shavyy/Automated_Chess/20_schema/Hall sensor board/readme.txt

https://easyeda.com/editor#id=ab28c445c3c246c5a2a266b23222d452|cde10e1112164b658e3af7a17f8cf5f8|bc72eab7fff44d6e881abe3bf44bdedf
