shavyy/Automated_Chess/00_Datasheet/sg90_spec.png

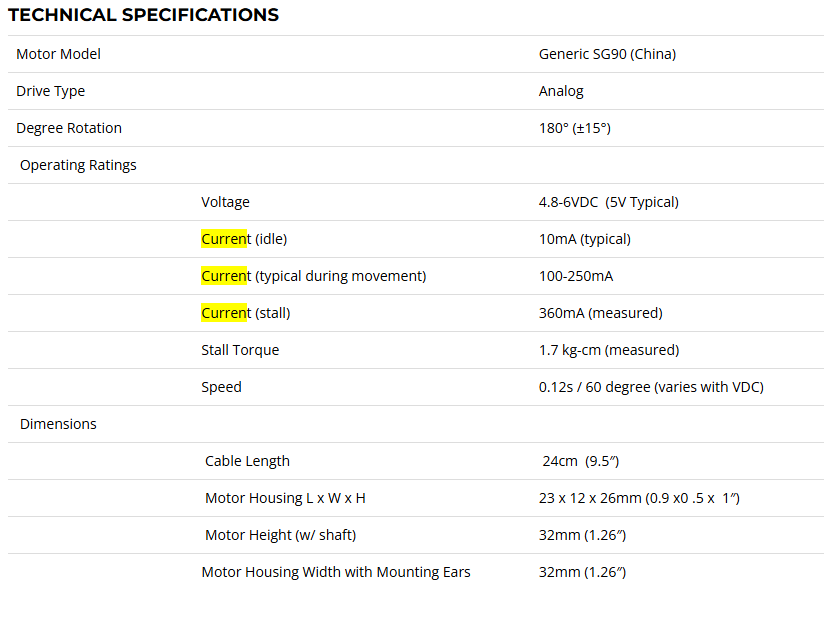
00_Datasheet/sg90_spec.png
