shavyy/Automated_Chess/10_Image/01630_6.jpg

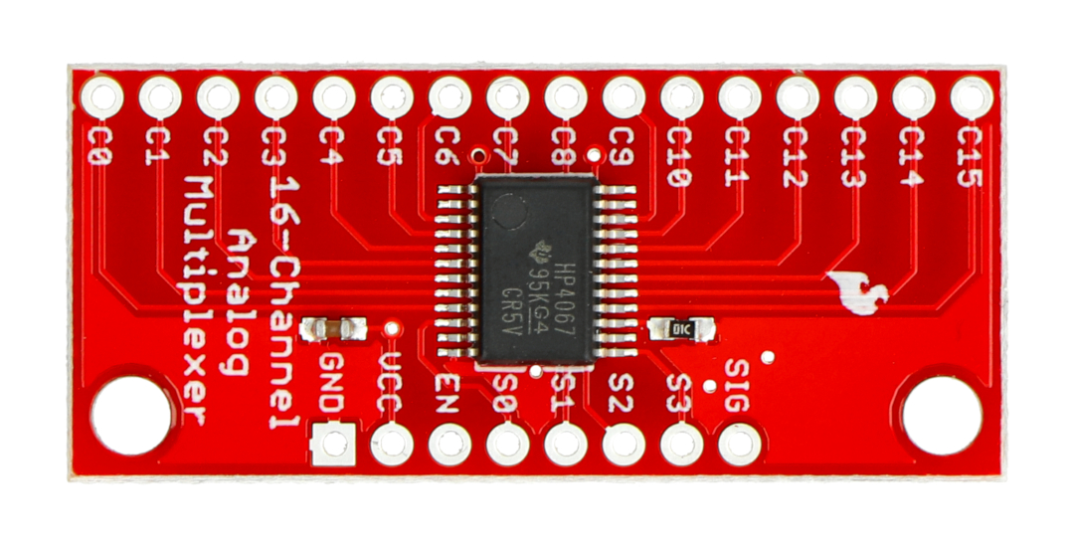
10_Image/01630_6.jpg
