shavyy/Automated_Chess/10_Image/arbredeDécision0.jpg

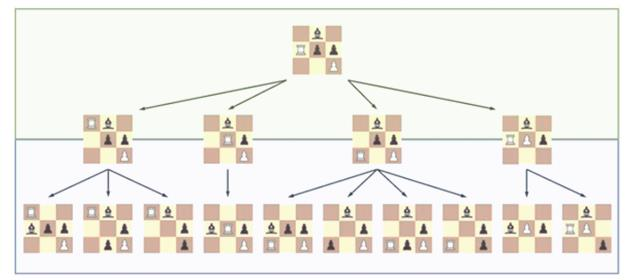
10_Image/arbredeDécision0.jpg
