shavyy/Automated_Chess/10_Image/arbreDeDécision1.jpg

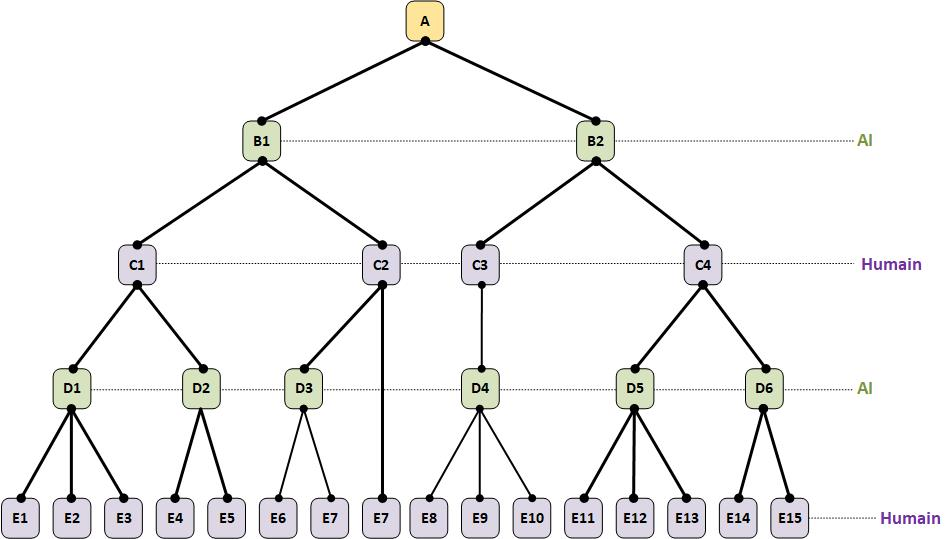
10_Image/arbreDeDécision1.jpg
