shavyy/Automated_Chess/10_Image/arbredeDécision2.jpg

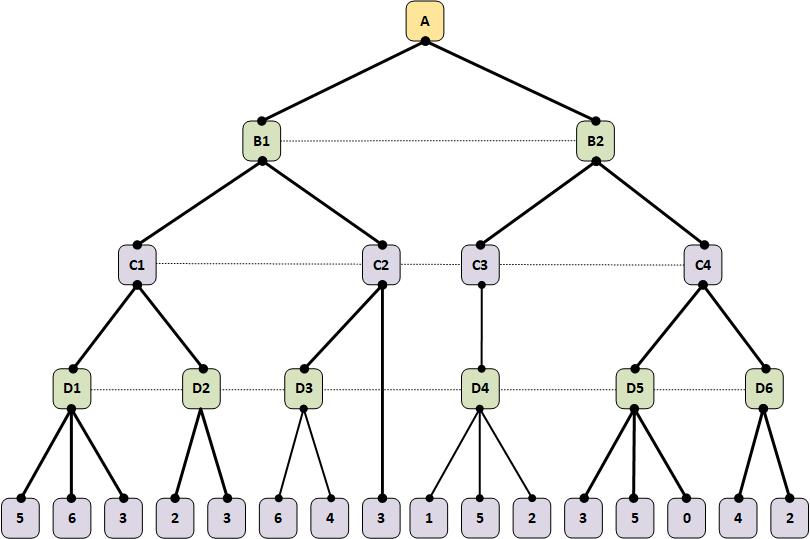
10_Image/arbredeDécision2.jpg
