shavyy/Automated_Chess/10_Image/arbredeDécision3.jpg

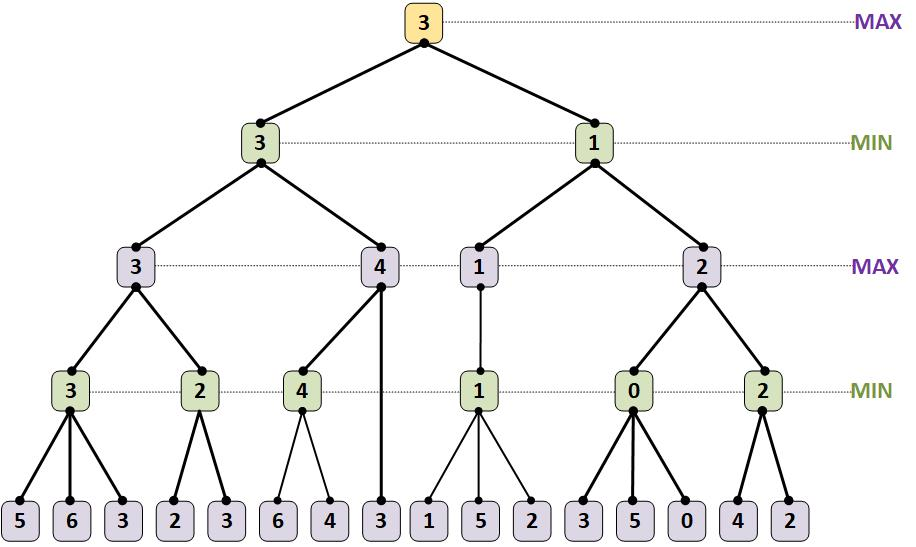
10_Image/arbredeDécision3.jpg
