shavyy/Automated_Chess/10_Image/arbreDeDécision4.jpg

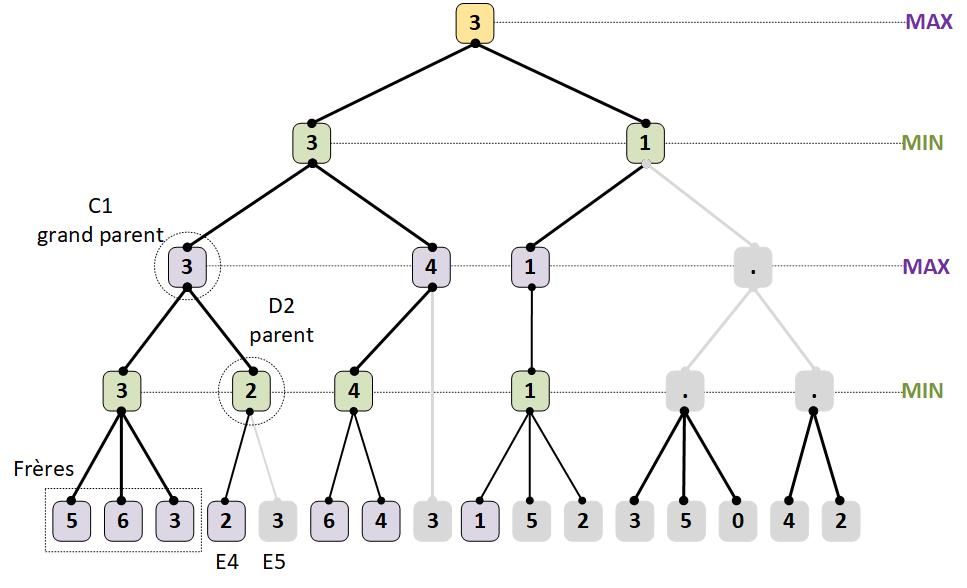
10_Image/arbreDeDécision4.jpg
