shavyy/Automated_Chess/10_Image/arduino_uno_bouton_poussoir.png

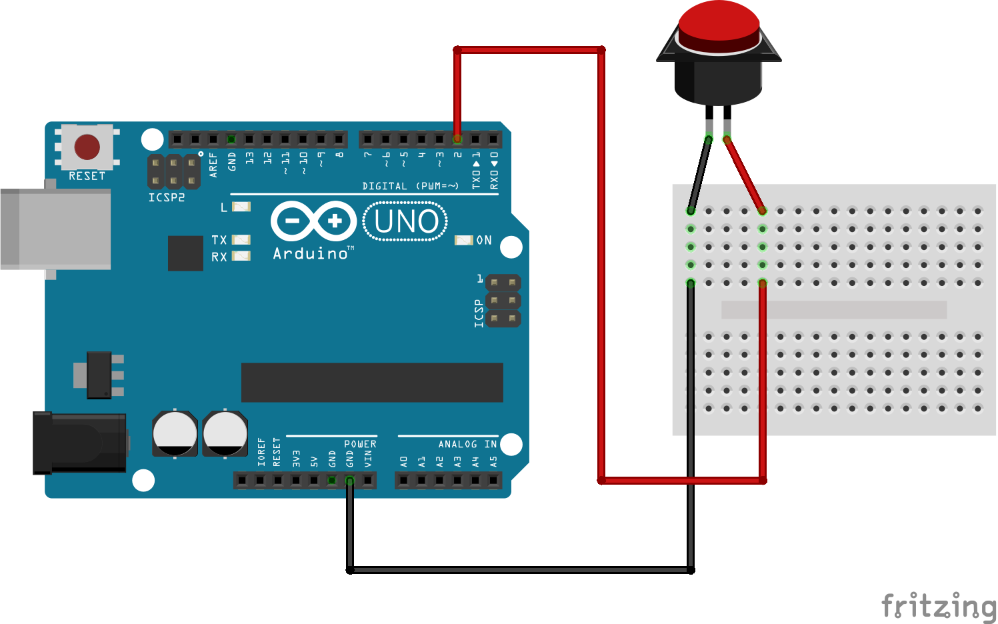
10_Image/arduino_uno_bouton_poussoir.png
