shavyy/Automated_Chess/10_Image/buzzer.jpg

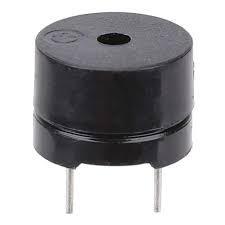
10_Image/buzzer.jpg
