shavyy/Automated_Chess/10_Image/DRV8825-Stepper-Driver-Pinout.jpg

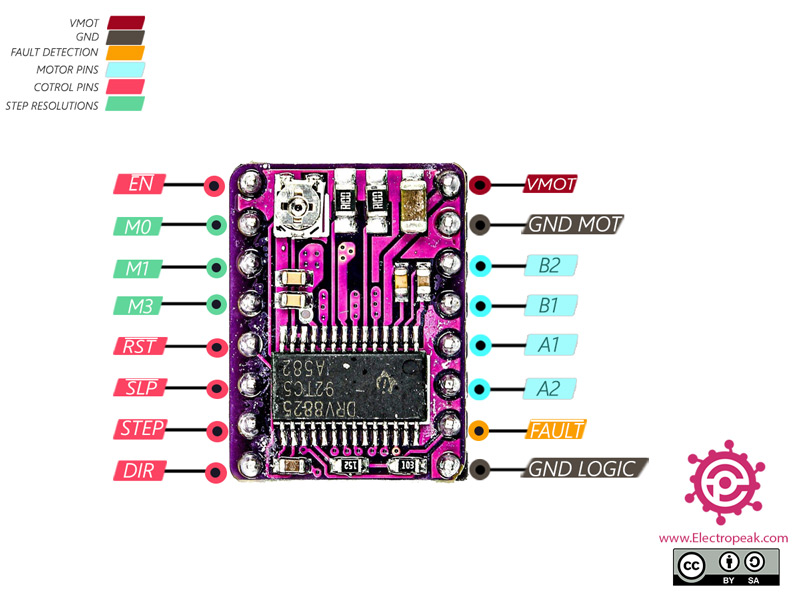
10_Image/DRV8825-Stepper-Driver-Pinout.jpg
