shavyy/Automated_Chess/10_Image/Interfacing-NEMA17-Stepper-Motor-with-ESP8266-using-DRV8825.jpg

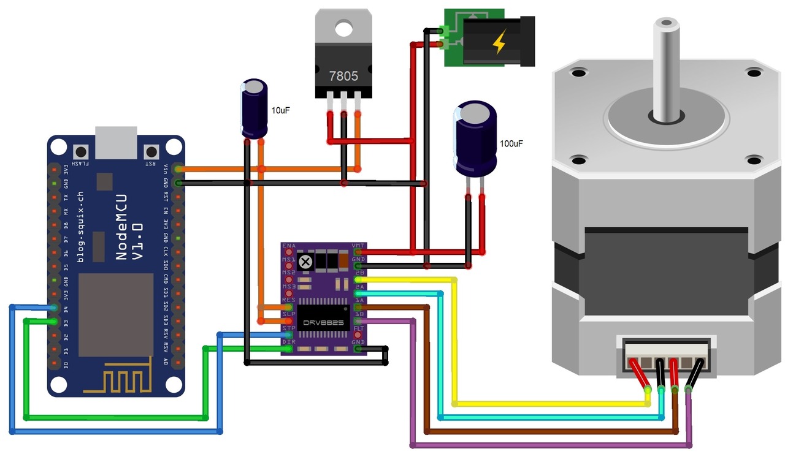
10_Image/Interfacing-NEMA17-Stepper-Motor-with-ESP8266-using-DRV8825.jpg
