shavyy/Automated_Chess/10_Image/layout_41uyAShgS7.jpg

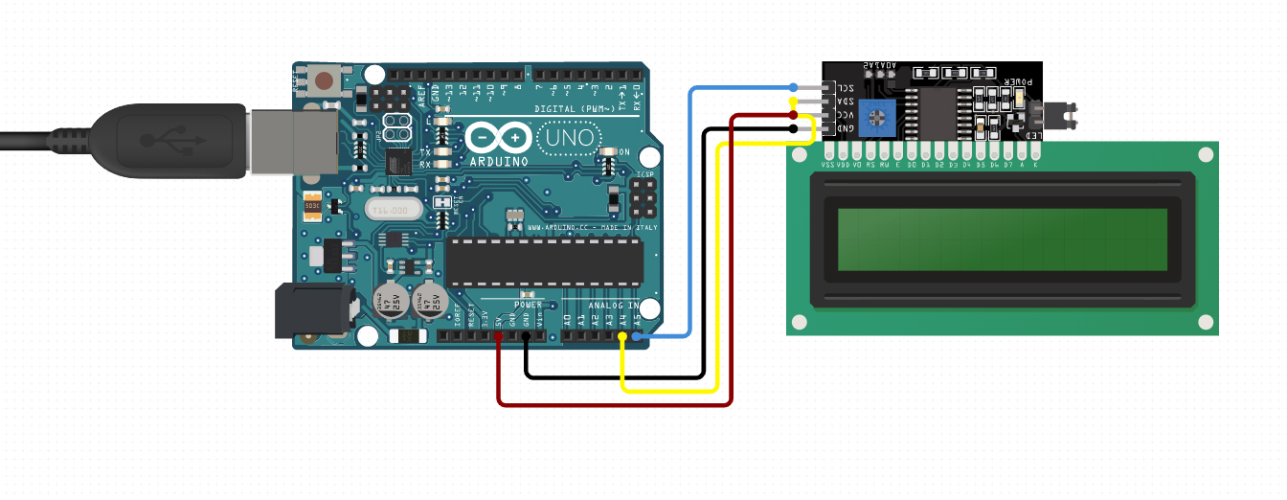
10_Image/layout_41uyAShgS7.jpg
