shavyy/Automated_Chess/10_Image/microswitch-edmatyer.jpg

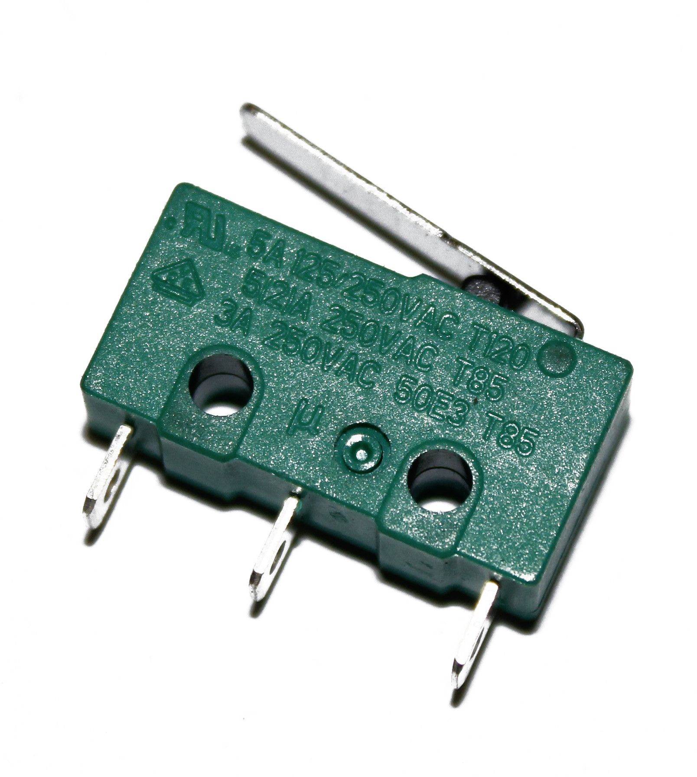
10_Image/microswitch-edmatyer.jpg
