shavyy/Automated_Chess/10_Image/motor-driver-dual-h-bridge-l298n-2.jpg

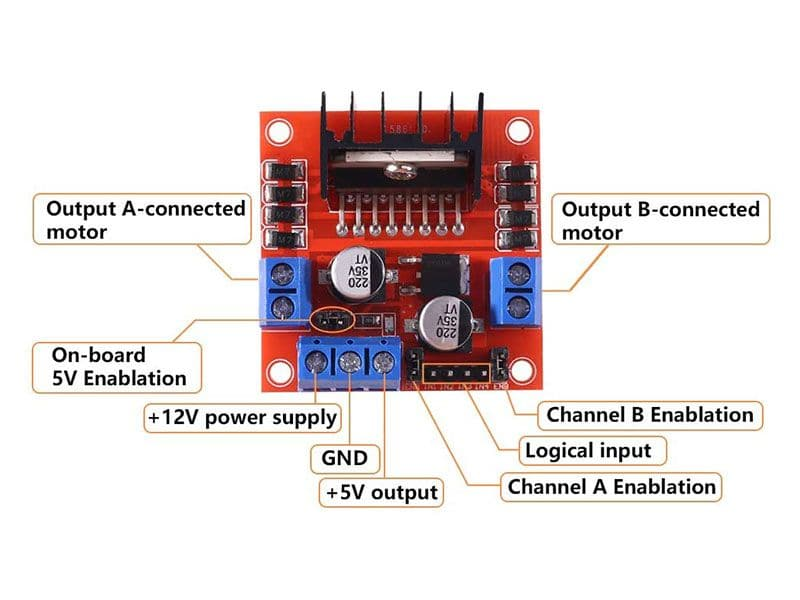
10_Image/motor-driver-dual-h-bridge-l298n-2.jpg
