shavyy/Automated_Chess/10_Image/NEMA17.jpg

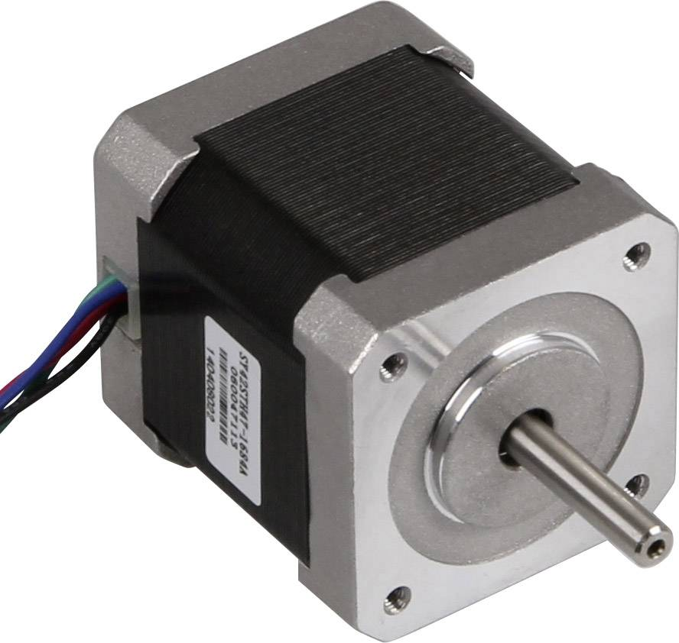
10_Image/NEMA17.jpg
