shavyy/Automated_Chess/10_Image/power-supply-12v-arduino-125-a-21-mm-jack.jpg

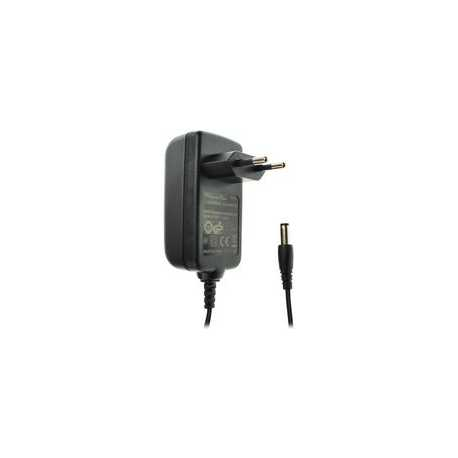
10_Image/power-supply-12v-arduino-125-a-21-mm-jack.jpg
