shavyy/Automated_Chess/10_Image/téléchargement.jpg

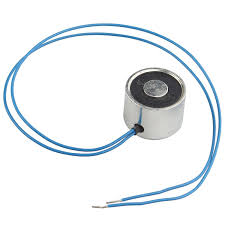
10_Image/téléchargement.jpg
