shavyy/Automated_Chess/10_Image/WdUnn.png

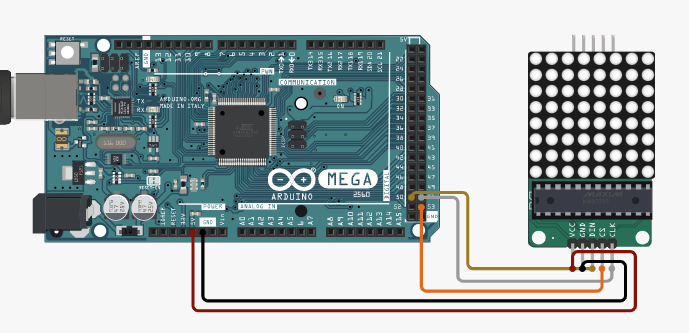
10_Image/WdUnn.png
