shavyy/Automated_Chess/20_schema/Hall sensor board/Schematic_automated_chess_2025-01-17.png

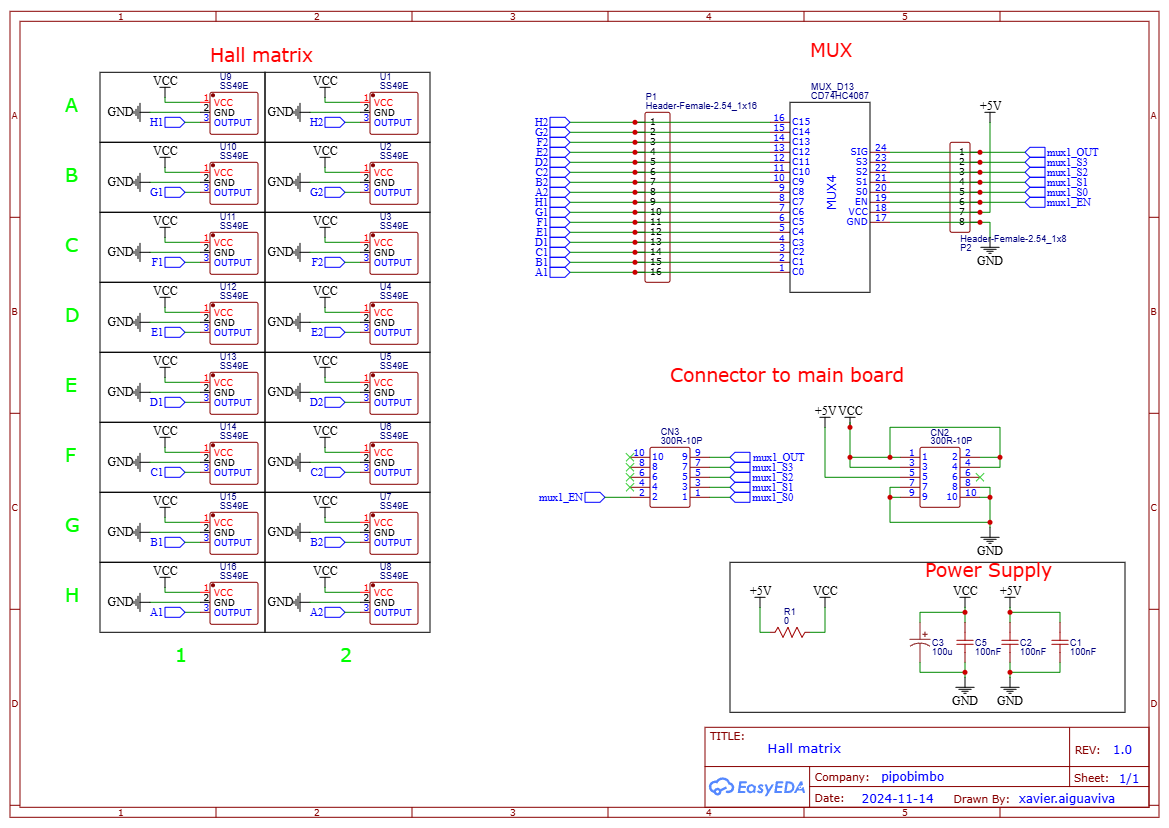
20_schema/Hall sensor board/Schematic_automated_chess_2025-01-17.png
