shavyy/Automated_Chess/BOM.xlsx

Sheet: Total
Type | Price
Electronic | 114.26 €
xy table | 27.38 €
Transmission | 17.10 €
box | 3.69 €
bolting | 22.97 €
Chess | 7.69 €
Impression 3D | 89.82 €
282.91 €

Sheet: electronic
Cart | Ordered | Received |  | Qty | Price U | Price tot
OK | OK | OK | 2 x Stepper Motor - Adafruit - Nema 17 size - 200 steps/rev, 12V 350mA 12V | 2 | 17.37 | 34.74 |  | https://www.amazon.fr/STEPPERONLINE-Bipolaire-42x34mm-Imprimante-Machine/dp/B00PNEQ9T4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
OK | OK | OK | 5Pcs DRV8825 Stepper Driver + Mega2560 Motherboard + Ramps1.4 Control Panel for 3D Printer | 1 | 18.59 | 18.59 |  | https://fr.aliexpress.com/item/1005004858805354.html?utparam-url=scene%3Asearch%7Cquery_from%3A
 |  |  | 1 x LCD Module - I2C Serial - 2.6“ | 0 |  | 0.00
 |  |  | 2 x Arcade button - Bore hole 23.5 mm | 0 |  | 0.00
OK | OK | OK | 1 x Electromagnet - 15Kg Holding Force 12V D30H25 | 2 | 3.03 | 6.06 | x1 | https://fr.aliexpress.com/item/1005007265254207.html?utparam-url=scene%3Asearch%7Cquery_from%3A
OK | OK | OK | L298N | 3 | 1.80 | 5.40 | x1 | https://fr.aliexpress.com/item/32392774289.html?utparam-url=scene%3Asearch%7Cquery_from%3A
 |  |  | 2 x Micro Limit switch roller | 0 |  | 0.00
OK | OK | OK | 64x EPLZON 49E OH49E SS49E TO-92S | 7 | 1.63 | 11.41 | x10 | https://fr.aliexpress.com/item/1005006061649001.html?utparam-url=scene%3Asearch%7Cquery_from%3A
OK | OK | OK | 4 x MUX breakout - SparkFun - CD74HC4067 | 1 | 4.59 | 4.59 | x10 | https://fr.aliexpress.com/item/1005006477925546.html?utparam-url=scene%3Asearch%7Cquery_from%3A
 |  |  | 3 x Prototyping Board - 50 x 100 mm | 0 |  | 0.00
OK | OK | OK | Female Headers | 2 | 1.52 | 3.04 | x10 | https://fr.aliexpress.com/item/4001198421663.html?utparam-url=scene%3Asearch%7Cquery_from%3A
 |  |  | 8 x Ribbon Cable - 8 | 0 | 7.99 | 0.00 | 6m | https://www.amazon.fr/QWORK-Couleur-Arc-En-Ciel-broches-Connecteurs/dp/B09R42ZGQD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
 |  |  | 1x Power supply 12V | 0 | 9.79 | 0.00 |  | https://www.amazon.fr/Transformateur-Adaptateur-Bande-Alimentation-V-220/dp/B01G0Q3RWU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
OK | OK | OK | 1x Power supply 12V | 1 | 3.65 | 3.65 |  | https://fr.aliexpress.com/item/1005006237300485.html?utparam-url=scene%3Asearch%7Cquery_from%3A
OK | OK | OK | 1x Power supply 5V | 1 | 2.44 | 2.44 |  | https://fr.aliexpress.com/item/1005006975464963.html?utparam-url=scene%3Asearch%7Cquery_from%3A
OK | OK | OK | kit resistor | 1 | 2.64 | 2.64 | x300 | https://fr.aliexpress.com/item/1005004933865451.html?utparam-url=scene%3Asearch%7Cquery_from%3A
OK | OK | OK | Etain | 2 | 2.05 | 4.10 |  | https://fr.aliexpress.com/item/1005006310000213.html?utparam-url=scene%3Asearch%7Cquery_from%3A
OK | OK | OK | wire | 1 | 1.30 | 1.30 | x120 | https://fr.aliexpress.com/item/1005007080948429.html?utparam-url=scene%3Asearch%7Cquery_from%3A
OK | OK | OK | PCB Hall sensor | 5 | 3.26 | 16.30
 |  |  |  |  |  | 114.26 €

Sheet: xy table
Cart | Ordered | Received |  | qty | Price U | Price tot
OK | OK | OK | 2 x V slot 20x20 linear rail, Length = 345 mm | 1 | 16.39 € | 16.39 € | x4 400mm | https://fr.aliexpress.com/item/1005003299342998.html?src=google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
 |  |  | 1 x V slot 20x20 linear rail, Length = 315 mm | 0 |  | 0.00
 |  |  | 1 x V slot 20x20 linear rail, Length = 350 mm | 0 |  | 0.00
 |  |  | 1 x V slot 20x20 linear rail, Length = 395 mm | 0 |  | 0.00
OK | OK | OK | 10 x 90 degree Corner Bracket | 1 | 10.99 | 10.99 | x10 | https://www.amazon.fr/AUTOUTLET-%C3%A9querres-int%C3%A9rieures-rainur%C3%A9es-Aluminium/dp/B07PJNNP6N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
 |  |  |  |  |  | 27.38 €

Sheet: Transmission
Cart | Ordered | Received |  | qty | Price U | Price tot
OK | OK | OK | 2 x GT2 Pulley, 20 teeth, 5mm bore | 1 | 5.29 € | 5.29 € | x2 | https://fr.aliexpress.com/item/33002989677.html?utparam-url=scene%3Asearch%7Cquery_from%3A
OK | OK | OK | 8 x GT2 Toothless pulley | 1 | 8.49 | 8.49 | x10 | https://fr.aliexpress.com/item/1005003693817340.html?utparam-url=scene%3Asearch%7Cquery_from%3A
OK | OK | OK | 3.5m x GT2 Belt | 1 | 3.32 | 3.32 | 5m | https://fr.aliexpress.com/item/10000401582873.html?utparam-url=scene%3Asearch%7Cquery_from%3A
 |  |  |  |  |  | 17.10 €

Sheet: box
Cart | Ordered | Received |  | qty | Price U | Price tot
OK | OK | OK | 1 x Foamboard - 462 x 462 x 5 mm | 1 | 3.69 € | 3.69 € | x3 | https://fr.aliexpress.com/item/1005006306052205.html?utparam-url=scene%3Asearch%7Cquery_from%3A
 |  |  | 1 x Foamboard - 462 x 462 x 10 mm | 0 |  | 0.00
 |  |  | 2 x Foamboard - 462 x 80 x 10 mm | 0 |  | 0.00
 |  |  | 2 x Foamboard - 442 x 80 x 10 mm | 0 |  | 0.00
 |  |  |  |  |  | 3.69 €

Sheet: bolting
Cart | Ordered | Received |  | qty | Price U | Price tot
OK | OK | OK | 8 x Mini V Wheel | 1 | 8.59 € | 8.59 € | x12 | https://fr.aliexpress.com/item/1005006057691968.html?utparam-url=scene%3Asearch%7Cquery_from%3A
 |  |  | 4 x Aluminium Spacer - ID : 5mm - Height : 6mm | 1 | 7.99 | 7.99 | x40 | https://www.amazon.fr/QUARKZMAN-Entretoise-Aluminium-Ext%C3%A9rieur-M%C3%A9tallique/dp/B0D3G5C3BB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
OK | OK | OK | 4 x Eccentric Spacer - M5 | 1 | 7.99 | 7.99 | x40 | https://www.amazon.fr/Evemodel-entretoises-Rondelles-Rangement-Accessoires/dp/B0B2HTRWTY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
 |  |  | 4 x Hex. Locking Nut - M5 | 4 |  | 0.00
 |  |  | 4 x Thin Hex. Nut - M5 | 4 |  | 0.00
 |  |  | 8 x Mini Precision Shim - OD : 8 mm - ID : 5 mm - Thickness : 1 mm | 8 |  | 0.00
OK | OK | OK | 26 x T-Nuts - M5 | 1 | 6.99 | 6.99 | x50 | https://www.amazon.fr/Coulissants-Aluminium-Standard-Europ%C3%A9en-Extrusion/dp/B0B7W5D599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
 |  |  | 14 x Hex. Socket Button Head Cap Screw - M5 x 8 mm | 14 |  | 0.00
 |  |  | 12 x Hex. Socket Button Head Cap Screw - M5 x 12 mm | 12 |  | 0.00
 |  |  | 2 x Hex. Socket Button Head Cap Screw - M5 x 35 mm | 2 |  | 0.00
 |  |  | 2 x Hex. Socket Button Head Cap Screw - M5 x 30 mm | 2 |  | 0.00
 |  |  | 2 x Hex. Socket Button Head Cap Screw - M5 x 25 mm | 2 |  | 0.00
 |  |  | 8 x Hex. Socket Button Head Cap Screw - M5 x 15 mm | 8 |  | 0.00
 |  |  | 4 x Slotted Head Screw - M2 x 15 mm | 4 |  | 0.00
 |  |  | 4 x Nut - M2 | 4 |  | 0.00
 |  |  | 8 x Hex. Socket Head Cap Screw - M3 x 10 mm | 8 |  | 0.00
 |  |  | 1 x Hex. Socket Head Cap Screw - M4 x 15 mm | 1 |  | 0.00
 |  |  | 4 x Slotted Countersunk Head Screw - M5 x 20 mm | 4 |  | 0.00
 |  |  | 4 x Nut - M5 | 4 |  | 0.00
 |  |  |  |  |  | 22.97 €

Sheet: chess
Cart | Ordered | Received |  | Qty | Price U | Price tot
 |  |  | 1 x Chess pieces set - Staunton 3 | 0 |  | 0.00 €
 |  |  | 1 x Chessboard Sticker - Squares size : 37 x 37 mm | 0 |  | 0.00
OK | OK | OK | 32 x Magnet, Dia 8 x 3 mm | 1 | 7.69 | 7.69 | x100 | https://fr.aliexpress.com/item/1005007306506182.html?utparam-url=scene%3Asearch%7Cquery_from%3A
 |  |  |  |  |  | 7.69 €

Sheet: impression 3D
Cart | Ordered | Received |  | qty | Price U | Price tot
OK | OK | OK | Cable_Clip | 2 | 6.07 | 12.14 € | https://www.abeille3d.com/produit/impression-3d/
OK | OK | OK | Electromagnet_Support | 1 | 12.55 | 12.55 €
 |  |  | Electronic_Support_A |  |  | 0.00 €
 |  |  | Electronic_Support_B |  |  | 0.00 €
OK | OK | OK | Motor_Support_A | 1 | 12.63 € | 12.63 €
OK | OK | OK | Motor_Support_B | 1 | 12.63 € | 12.63 €
OK | OK | OK | Pulley_Support_A | 1 | 10.16 | 10.16 €
OK | OK | OK | Pulley_Support_B | 1 | 10.12 | 10.12 €
OK | OK | OK | Trolley_Support_A | 1 | 9.87 | 9.87 €
OK | OK | OK | Trolley_Support_B | 1 | 9.72 | 9.72 €
 |  |  |  |  |  | 89.82 €
