shavyy/Automated_Chess/100_Design/Design.xlsx

Sheet: Mapping AT2560
Atemga 2560
Pin Number | Pin Name | Mapped pin name | Component | Pin Name
1 | PG5 ( OC0B ) | Digital pin 4 (PWM) | Micro switch | LIMIT_SWITCH_WHITE
2 | PE0 ( RXD0/PCINT8 ) | Digital pin 0 (RX0)
3 | PE1 ( TXD0 ) | Digital pin 1 (TX0)
4 | PE2 ( XCK0/AIN0 )
5 | PE3 ( OC3A/AIN1 ) | Digital pin 5 (PWM) | Micro switch | LIMIT_SWITCH_WHITE
6 | PE4 ( OC3B/INT4 ) | Digital pin 2 (PWM)
7 | PE5 ( OC3C/INT5 ) | Digital pin 3 (PWM) | Mux | EN_MUX4
8 | PE6 ( T3/INT6 )
9 | PE7 ( CLKO/ICP3/INT7 )
10 | VCC | VCC
11 | GND | GND
12 | PH0 ( RXD2 ) | Digital pin 17 (RX2)
13 | PH1 ( TXD2 ) | Digital pin 16 (TX2)
14 | PH2 ( XCK2 )
15 | PH3 ( OC4A ) | Digital pin 6 (PWM)
16 | PH4 ( OC4B ) | Digital pin 7 (PWM)
17 | PH5 ( OC4C ) | Digital pin 8 (PWM)
18 | PH6 ( OC2B ) | Digital pin 9 (PWM)
19 | PB0 ( SS/PCINT0 ) | Digital pin 53 (SS) | LED matrix | CS
20 | PB1 ( SCK/PCINT1 ) | Digital pin 52 (SCK) | LED matrix | CLK
21 | PB2 ( MOSI/PCINT2 ) | Digital pin 51 (MOSI) | LED matrix | DIN
22 | PB3 ( MISO/PCINT3 ) | Digital pin 50 (MISO) | Servo_MOT | Servo_MOT
23 | PB4 ( OC2A/PCINT4 ) | Digital pin 10 (PWM)
24 | PB5 ( OC1A/PCINT5 ) | Digital pin 11 (PWM) | Button White | BUTTON_WHITE_SWITCH_MOTOR_WHITE
25 | PB6 ( OC1B/PCINT6 ) | Digital pin 12 (PWM)
26 | PB7 ( OC0A/OC1C/PCINT7 ) | Digital pin 13 (PWM)
27 | PH7 ( T4 )
28 | PG3 ( TOSC2 )
29 | PG4 ( TOSC1 )
30 | RESET | RESET
31 | VCC | VCC
32 | GND | GND
33 | XTAL2 | XTAL2
34 | XTAL1 | XTAL1
35 | PL0 ( ICP4 ) | Digital pin 49
36 | PL1 ( ICP5 ) | Digital pin 48
37 | PL2 ( T5 ) | Digital pin 47
38 | PL3 ( OC5A ) | Digital pin 46 (PWM)
39 | PL4 ( OC5B ) | Digital pin 45 (PWM)
40 | PL5 ( OC5C ) | Digital pin 44 (PWM) | Mux | EN_MUX2
41 | PL6 | Digital pin 43
42 | PL7 | Digital pin 42 | Mux | EN_MUX3
43 | PD0 ( SCL/INT0 ) | Digital pin 21 (SCL) | LCD | LCD_SCL
44 | PD1 ( SDA/INT1 ) | Digital pin 20 (SDA) | LCD | LCD_SDA
45 | PD2 ( RXDI/INT2 ) | Digital pin 19 (RX1) | H-bridge Magnet | Enable
46 | PD3 ( TXD1/INT3 ) | Digital pin 18 (TX1) | H-bridge Magnet | IN2
47 | PD4 ( ICP1 )
48 | PD5 ( XCK1 )
49 | PD6 ( T1 )
50 | PD7 ( T0 ) | Digital pin 38
51 | PG0 ( WR ) | Digital pin 41
52 | PG1 ( RD ) | Digital pin 40 | Mux | EN_MUX4
53 | PC0 ( A8 ) | Digital pin 37
54 | PC1 ( A9 ) | Digital pin 36 | Motor Black | MOTOR_BLACK_DIR
55 | PC2 ( A10 ) | Digital pin 35
56 | PC3 ( A11 ) | Digital pin 34 | Motor Black | MOTOR_BLACK_STEP
57 | PC4 ( A12 ) | Digital pin 33
58 | PC5 ( A13 ) | Digital pin 32
59 | PC6 ( A14 ) | Digital pin 31
60 | PC7 ( A15 ) | Digital pin 30 | Motor Black | MOTOR_BLACK_EN
61 | VCC | VCC
62 | GND | GND
63 | PJ0 ( RXD3/PCINT9 ) | Digital pin 15 (RX3)
64 | PJ1 ( TXD3/PCINT10 ) | Digital pin 14 (TX3) | Mux | EN_MUX4
65 | PJ2 ( XCK3/PCINT11 )
66 | PJ3 ( PCINT12 )
67 | PJ4 ( PCINT13 )
68 | PJ5 ( PCINT14 )
69 | PJ6 ( PCINT 15 )
70 | PG2 ( ALE ) | Digital pin 39
71 | PA7 ( AD7 ) | Digital pin 29
72 | PA6 ( AD6 ) | Digital pin 28 | Motor White | MOTOR_WHITE_STEP
73 | PA5 ( AD5 ) | Digital pin 27
74 | PA4 ( AD4 ) | Digital pin 26 | Motor White | MOTOR_WHITE_DIR
75 | PA3 ( AD3 ) | Digital pin 25 | Mux | EN_MUX4
76 | PA2 ( AD2 ) | Digital pin 24
77 | PA1 ( AD1 ) | Digital pin 23 | Motort White | MOTOR_WHITE_EN
78 | PA0 ( AD0 ) | Digital pin 22
79 | PJ7
80 | VCC | VCC
81 | GND | GND
82 | PK7 ( ADC15/PCINT23 ) | Analog pin 15 | H-bridge Magnet | IN1
83 | PK6 ( ADC14/PCINT22 ) | Analog pin 14
84 | PK5 ( ADC13/PCINT21 ) | Analog pin 13
85 | PK4 ( ADC12/PCINT20 ) | Analog pin 12 | MUX | S3
86 | PK3 ( ADC11/PCINT19 ) | Analog pin 11 | MUX | S2
87 | PK2 ( ADC10/PCINT18 ) | Analog pin 10
88 | PK1 ( ADC9/PCINT17 ) | Analog pin 9 | MUX | S1
89 | PK0 ( ADC8/PCINT16 ) | Analog pin 8
90 | PF7 ( ADC7/TDI ) | Analog pin 7
91 | PF6 ( ADC6/TDO ) | Analog pin 6 | Button Black | BUTTON_BLACK_SWITCH_MOTOR_BLACK
92 | PF5 ( ADC5/TMS ) | Analog pin 5 | MUX | S0
93 | PF4 ( ADC4/TCK ) | Analog pin 4 | Mux | Mux_out
94 | PF3 ( ADC3 ) | Analog pin 3 | Buzzer | pin_buzzer
95 | PF2 ( ADC2 ) | Analog pin 2
96 | PF1 ( ADC1 ) | Analog pin 1
97 | PF0 ( ADC0 ) | Analog pin 0
98 | AREF | Analog Reference
99 | GND | GND
100 | AVCC | VCC

Sheet: Power Tree
 | P12V
 | Component | Current | Power | qty | Current | Power
12 | Stepper Motor - Adafruit - Nema 17 size - 200 steps/rev, 12V 350mA 12V | 0.8A | 9.6W | 2 | 1.6A | 19.2W
 | Electromagnet - 5Kg Holding Force 12V | 0.25A | 3W | 1 | 0.25A | 3W
 | DRV8825 | 0.008A | 0.04W | 2 | 0.016A | 0.08W
 | L298N | 0.106A | 0.53W | 1 | 0.106A | 0.53W
 | Total |  |  |  | 1.972A | 22.81W
 | P5V
5 | Component | Current | Power | qty | Current | Power | DO measurement !!!
 | Arduino 2560 rev 3 | 0.71A | 3.55W | 1 | 0.71A | 3.55W
 | LCD Module - I2C Serial | 0.05A | 0.25W | 1 | 0.05A | 0.25W | https://docs.arduino.cc/resources/datasheets/A000067-datasheet.pdf
 | Matrix LED max7219-dotmatrix-V02 | 0.5A | 2.5W | 1 | 0.5A | 2.5W
 | Total |  |  |  | 1.26A | 6.3W
 | P6V5
6 | Component | Current | Power | qty | Current | Power
 | 49E OH49E SS49E TO-92S | 0.01A | 0.06W | 64 | 0.64A | 3.84W
 | CD74HC4067 | 0.05A | 0.3W | 4 | 0.2A | 1.2W
 | Total |  |  |  | 0.84A | 5.04W

Sheet: Hall sensor matrix
 |  |  |  |  |  |  |  |  |  |  |  |  |  | MUX CD4067 |  |  |  |  |  |  | tph=650ns
 |  | Chess coordinate |  |  |  |  |  |  |  |  |  | Black side |  | Hall 49e | Mux 1 | Mux 2 | Mux 3 | Mux 4 | Table column | Table raw
 |  |  |  |  |  |  |  |  |  |  |  | majuscule |  | A1 | C7 |  |  |  | 0 | 0
 |  |  | 8 | r | n | b | q | k | b | n | r |  | Motor #2 | A2 | C14 |  |  |  | 1 | 0
 |  |  | 7 | p | p | p | p | p | p | p | p |  | Dir (TBC) | A3 |  | C7 |  |  | 2 | 0
 |  |  | 6 | . | . | . | . | . | . | . | . |  |  | A4 |  | C14 |  |  | 3 | 0
 |  |  | 5 | . | . | . | . | . | . | . | . |  |  | A5 |  |  | C7 |  | 4 | 0
 |  |  | 4 | . | . | . | . | . | . | . | . |  |  | A6 |  |  | C14 |  | 5 | 0
 |  |  | 3 | . | . | . | . | . | . | . | . |  |  | A7 |  |  |  | C7 | 6 | 0
 |  |  | 2 | P | P | P | P | P | P | P | P |  | Motor #1 | A8 |  |  |  | C14 | 7 | 0
 |  |  | 1 | R | N | B | Q | K | B | N | R |  | Dir (TBC) | B1 | C6 |  |  |  | 0 | 1
 |  |  |  | a | b | c | d | e | f | g | h | White side |  | B2 | C14 |  |  |  | 1 | 1
 |  |  |  |  |  |  |  |  |  |  |  | Minuscule |  | B3 |  | C6 |  |  | 2 | 1
 |  |  |  |  |  |  |  |  |  |  |  |  |  | B4 |  | C14 |  |  | 3 | 1
 |  |  |  |  |  |  |  |  |  |  |  |  |  | B5 |  |  | C6 |  | 4 | 1
 |  |  |  |  |  |  |  |  |  |  |  |  |  | B6 |  |  | C14 |  | 5 | 1
 |  | Polarité aimant |  |  |  |  |  |  |  |  |  |  |  | B7 |  |  |  | C6 | 6 | 1
Black side |  |  |  | 0 | 1 | 2 | 3 | 4 | 5 | 6 | 7 | matrix code |  | B8 |  |  |  | C14 | 7 | 1
-1 |  | 7 | 8 | 1 | 1 | 1 | 1 | 1 | 1 | 1 | 1 |  |  | C1 | C5 |  |  |  | 0 | 2
 |  | 6 | 7 | 1 | 1 | 1 | 1 | 1 | 1 | 1 | 1 |  |  | C2 | C13 |  |  |  | 1 | 2
 |  | 5 | 6 | 0 | 0 | 0 | 0 | 0 | 0 | 0 | 0 |  |  | C3 |  | C5 |  |  | 2 | 2
 |  | 4 | 5 | 0 | 0 | 0 | 0 | 0 | 0 | 0 | 0 |  |  | C4 |  | C13 |  |  | 3 | 2
 |  | 3 | 4 | 0 | 0 | 0 | 0 | 0 | 0 | 0 | 0 |  |  | C5 |  |  | C5 |  | 4 | 2
 |  | 2 | 3 | 0 | 0 | 0 | 0 | 0 | 0 | 0 | 0 |  |  | C6 |  |  | C13 |  | 5 | 2
White side |  | 1 | 2 | -1 | -1 | -1 | -1 | -1 | -1 | -1 | -1 |  |  | C7 |  |  |  | C5 | 6 | 2
1 |  | 0 | 1 | -1 | -1 | -1 | -1 | -1 | -1 | -1 | -1 |  |  | C8 |  |  |  | C13 | 7 | 2
 |  |  |  | a | b | c | d | e | f | g | h |  |  | D1 | C4 |  |  |  | 0 | 3
 |  |  |  |  |  |  |  |  |  |  |  |  |  | D2 | C12 |  |  |  | 1 | 3
 |  |  |  |  |  |  |  |  |  |  |  |  |  | D3 |  | C4 |  |  | 2 | 3
 |  |  |  |  |  |  |  |  |  |  |  |  |  | D4 |  | C12 |  |  | 3 | 3
 |  | Mux |  |  |  |  |  |  |  |  |  |  |  | D5 |  |  | C4 |  | 4 | 3
 |  |  |  | 0 | 1 | 2 | 3 | 4 | 5 | 6 | 7 |  |  | D6 |  |  | C12 |  | 5 | 3
Black side |  | 7 | 8 | -1 | -1 | -1 | -1 | -1 | -1 | -1 | -1 |  | Mux 4 | D7 |  |  |  | C4 | 6 | 3
-1 |  | 6 | 7 | -1 | -1 | -1 | -1 | -1 | -1 | -1 | -1 |  |  | D8 |  |  |  | C12 | 7 | 3
 |  | 5 | 6 | 0 | 0 | 0 | 0 | 0 | 0 | 0 | 0 |  | Mux 3 | E1 | C3 |  |  |  | 0 | 4
 |  | 4 | 5 | 0 | 0 | 0 | 0 | 0 | 0 | 0 | 0 |  |  | E2 | C11 |  |  |  | 1 | 4
 |  | 3 | 4 | 0 | 0 | 0 | 0 | 0 | 0 | 0 | 0 |  | Mux 2 | E3 |  | C3 |  |  | 2 | 4
 |  | 2 | 3 | 0 | 0 | 0 | 0 | 0 | 0 | 0 | 0 |  |  | E4 |  | C11 |  |  | 3 | 4
White side |  | 1 | 2 | 1 | 1 | 1 | 1 | 1 | 1 | 1 | 1 |  | Mux1 | E5 |  |  | C3 |  | 4 | 4
1 |  | 0 | 1 | 1 | 1 | 1 | 1 | 1 | 1 | 1 | 1 |  |  | E6 |  |  | C11 |  | 5 | 4
 |  |  |  | a | b | c | d | e | f | g | h |  |  | E7 |  |  |  | C3 | 6 | 4
 |  |  |  |  |  |  |  |  |  |  |  |  |  | E8 |  |  |  | C11 | 7 | 4
 |  |  |  |  |  |  |  |  |  |  |  |  |  | F1 | C2 |  |  |  | 0 | 5
 |  |  |  |  |  |  |  |  |  |  |  |  |  | F2 | C10 |  |  |  | 1 | 5
 |  | Example |  |  |  |  |  |  |  |  |  |  |  | F3 |  | C2 |  |  | 2 | 5
 |  |  |  | 0 | 1 | 2 | 3 | 4 | 5 | 6 | 7 |  |  | F4 |  | C10 |  |  | 3 | 5
Black side |  | 7 | 8 | 0 | 0 | 0 | 0 | -1 | 0 | 0 | 0 |  |  | F5 |  |  | C2 |  | 4 | 5
-1 |  | 6 | 7 | 0 | 0 | 0 | 0 | 0 | 0 | 0 | 0 |  |  | F6 |  |  | C10 |  | 5 | 5
 |  | 5 | 6 | 0 | 0 | 1 | 0 | -1 | 1 | 0 | 0 |  |  | F7 |  |  |  | C2 | 6 | 5
 |  | 4 | 5 | 0 | 0 | 0 | 0 | 1 | 0 | 0 | 0 |  |  | F8 |  |  |  | C10 | 7 | 5
 |  | 3 | 4 | 0 | 0 | 0 | 0 | 1 | 0 | 0 | 0 |  |  | G1 | C1 |  |  |  | 0 | 6
 |  | 2 | 3 | 0 | 0 | 0 | 0 | 0 | 0 | 0 | 0 |  |  | G2 | C9 |  |  |  | 1 | 6
White side |  | 1 | 2 | 0 | 0 | 0 | 0 | 0 | 0 | 0 | 0 |  |  | G3 |  | C1 |  |  | 2 | 6
1 |  | 0 | 1 | 0 | 0 | 0 | 0 | 0 | 0 | 0 | 0 |  |  | G4 |  | C9 |  |  | 3 | 6
 |  |  |  | a | b | c | d | e | f | g | h |  |  | G5 |  |  | C1 |  | 4 | 6
 |  |  |  |  |  |  |  |  |  |  |  |  |  | G6 |  |  | C9 |  | 5 | 6
 |  |  |  |  |  |  |  |  |  |  |  |  |  | G7 |  |  |  | C1 | 6 | 6
 | Hall sensor allows to differenciate black/white/no piece on the board instead of reed relay (binary) |  |  |  |  |  |  |  |  |  |  |  |  | G8 |  |  |  | C9 | 7 | 6
 | Add acquisition channel to 49e to increase accuracy? |  |  |  |  |  |  |  |  |  |  |  |  | H1 | C0 |  |  |  | 0 | 7
 |  |  |  |  |  |  |  |  |  |  |  |  |  | H2 | C8 |  |  |  | 1 | 7
 |  |  |  |  |  |  |  |  |  |  |  |  |  | H3 |  | C0 |  |  | 2 | 7
 |  |  |  |  |  |  |  |  |  |  |  |  |  | H4 |  | C8 |  |  | 3 | 7
 |  |  |  |  |  |  |  |  |  |  |  |  |  | H5 |  |  | C0 |  | 4 | 7
 |  |  |  |  |  |  |  |  |  |  |  |  |  | H6 |  |  | C8 |  | 5 | 7
 |  |  |  |  |  |  |  |  |  |  |  |  |  | H7 |  |  |  | C0 | 6 | 7
 |  |  |  |  |  |  |  |  |  |  |  |  |  | H8 |  |  |  | C8 | 7 | 7

Sheet: Hall sensor Calcul
Need to calibrate Hall sensor |  |  |  | Test Results |  |  |  |  |  |  |  |  |  |  |  | Power supply = 5,00V |  |  | Test Results |  |  |  |  |  |  |  |  |  |  |  | Power supply = 6,00V
 |  |  |  |  | Hall measure 1 (bit) |  |  |  |  |  |  |  |  |  |  | ADC 2^10 bit (1024) |  |  |  | Hall measure 1 (bit) |  |  |  |  |  |  |  |  |  |  | ADC 2^10 bit (1024)
 |  |  |  |  |  |  | 0 | 1 | 2 | 3 | 4 | 5 | 6 | 7 |  | Hall no piece min = | 486 |  |  |  |  | 0 | 1 | 2 | 3 | 4 | 5 | 6 | 7 |  | Hall no piece min = | 580
 |  |  | Black side |  | 7 | 8 |  |  |  |  |  |  |  |  |  | Hall no piece max = | 584 | Black side |  | 7 | 8 |  |  |  |  |  |  |  |  |  | Hall no piece max = | 660
 | Vcc | 6 V | -1 |  | 6 | 7 |  |  |  |  |  |  |  |  |  |  |  | -1 |  | 6 | 7
 | Sensitivity | 1.68 mV/G |  |  | 5 | 6 |  |  |  |  |  |  |  |  |  |  |  |  |  | 5 | 6
 |  |  |  |  | 4 | 5 |  |  |  |  |  |  |  |  |  |  |  |  |  | 4 | 5
 |  |  |  |  | 3 | 4 |  |  |  |  |  |  |  |  |  |  |  |  |  | 3 | 4
 |  |  |  |  | 2 | 3 |  |  |  |  |  |  |  |  |  |  |  |  |  | 2 | 3
 | SS49e Theoretical |  | White side |  | 1 | 2 |  |  |  |  |  |  |  |  |  |  |  | White side |  | 1 | 2
 | Gauss | Voltage | 1 |  | 0 | 1 |  |  |  |  |  |  |  |  | 0,9V |  |  | 1 |  | 0 | 1 |  |  |  |  |  |  |  |  | 0,9V
 | -1200 G | 0.984 V |  |  |  |  | a | b | c | d | e | f | g | h |  |  |  |  |  |  |  | a | b | c | d | e | f | g | h
 | 1200 G | 5.016 V
 | a | 0.00168 |  |  | Hall measure 2 (bit) |  |  |  |  |  |  |  |  |  |  |  |  |  |  | Hall measure 2 (bit) |  |  |  |  |  |  |  |  |  |  | Augmenter l'alimentation permet d'améliorer la précision de mesure d'après la datasheet. Essayer 6V ou 6,5V
 | b | 3 |  |  |  |  | 0 | 1 | 2 | 3 | 4 | 5 | 6 | 7 |  |  |  |  |  |  |  | 0 | 1 | 2 | 3 | 4 | 5 | 6 | 7
 |  |  | Black side |  | 7 | 8 | 531 | 514 | 533 | 507 | 509 | 521 | 515 | 549 |  |  |  | Black side |  | 7 | 8 | 627 | 643 | 642 | 622 | 633 | 653 | 643 | 648
 | V | 1 | -1 |  | 6 | 7 | 524 | 545 | 528 | 515 | 507 | 525 | 555 | 517 |  |  |  | -1 |  | 6 | 7 | 626 | 649 | 631 | 639 | 631 | 638 | 610 | 643
 | G | 3.00168 |  |  | 5 | 6 | 549 | 540 | 495 | 531 | 523 | 570 | 525 | 553 |  |  |  |  |  | 5 | 6 | 640 | 637 | 648 | 634 | 636 | 646 | 632 | 646
 |  |  |  |  | 4 | 5 | 533 | 532 | 535 | 526 | 557 | 525 | 542 | 538 |  |  |  |  |  | 4 | 5 | 611 | 632 | 641 | 660 | 617 | 629 | 653 | 624
 |  |  |  |  | 3 | 4 | 501 | 546 | 532 | 584 | 511 | 526 | 556 | 510 |  |  |  |  |  | 3 | 4 | 607 | 609 | 605 | 602 | 611 | 602 | 586 | 614
 |  |  |  |  | 2 | 3 | 524 | 529 | 548 | 552 | 522 | 560 | 521 | 556 |  |  |  |  |  | 2 | 3 | 599 | 614 | 595 | 596 | 600 | 618 | 580 | 601
 |  |  | White side |  | 1 | 2 | 528 | 530 | 507 | 518 | 505 | 519 | 486 | 551 |  |  |  | White side |  | 1 | 2 | 625 | 619 | 630 | 619 | 602 | 614 | 616 | 617
 |  |  | 1 |  | 0 | 1 | 512 | 516 | 548 | 515 | 546 | 526 | 546 | 524 | 2,48V |  |  | 1 |  | 0 | 1 | 599 | 611 | 608 | 599 | 611 | 613 | 615 | 618 | 2,48V
 |  |  |  |  |  |  | a | b | c | d | e | f | g | h |  |  |  |  |  |  |  | a | b | c | d | e | f | g | h
 |  |  |  |  | Hall measure 3 (bit) |  |  |  |  |  |  |  |  |  |  |  |  |  |  | Hall measure 3 (bit)
 |  |  |  |  |  |  | 0 | 1 | 2 | 3 | 4 | 5 | 6 | 7 |  |  |  |  |  |  |  | 0 | 1 | 2 | 3 | 4 | 5 | 6 | 7
 |  |  | Black side |  | 7 | 8 |  |  |  |  |  |  |  |  |  |  |  | Black side |  | 7 | 8
 |  |  | -1 |  | 6 | 7 |  |  |  |  |  |  |  |  |  |  |  | -1 |  | 6 | 7
 |  |  |  |  | 5 | 6 |  |  |  |  |  |  |  |  |  |  |  |  |  | 5 | 6
 |  |  |  |  | 4 | 5 |  |  |  |  |  |  |  |  |  |  |  |  |  | 4 | 5
 |  |  |  |  | 3 | 4 |  |  |  |  |  |  |  |  |  |  |  |  |  | 3 | 4
 |  |  |  |  | 2 | 3 |  |  |  |  |  |  |  |  |  |  |  |  |  | 2 | 3
 |  |  | White side |  | 1 | 2 |  |  |  |  |  |  |  |  |  |  |  | White side |  | 1 | 2
 |  |  | 1 |  | 0 | 1 |  |  |  |  |  |  |  |  | 4,29V |  |  | 1 |  | 0 | 1 |  |  |  |  |  |  |  |  | 4,29V
 |  |  |  |  |  |  | a | b | c | d | e | f | g | h |  |  |  |  |  |  |  | a | b | c | d | e | f | g | h

Sheet: Motor Move
Cable XY choisis plutôt qu'un cablage cartesien,
Cela permet d'éviter d'avoir un moteur sur le chariot (et donc une meilleure intégration) et une plus grande plage de mouvement.
Cependant, le cablage est plus complexe et une précision de déplacement plus faible.
 |  |  |  |  |  |  |  |  |  |  |  |  |  |  |  |  |  |  |  |  |  |  |  |  |  |  |  |  | Table of truth
A chaque utilisation, la position du chariot est inconnu. Il doit revenir en position 0 en entrant en contact avec les capteurs fins de course. |  |  |  |  |  |  |  |  |  |  |  |  |  |  |  |  |  |  |  |  |  |  |  |  |  |  |  |  |  | DIR MOT |  | STEP MOT
 |  |  |  |  |  |  |  |  |  |  |  |  |  |  |  |  |  |  |  |  |  |  |  |  |  |  |  |  | Direction | White | Black | White | Black
 | Movimiento: |  |  |  | A | H |  |  |  |  |  |  |  |  | Movimiento: |  |  |  | H | A |  |  |  |  |  |  |  |  | H_A | 1 | 0 | 1 | 1 | DIR (White = 1) ==> H_A || 1_8 || HA_18 Sinon DIR (White = 0)
 |  |  |  |  |  |  |  |  |  |  |  |  |  |  |  |  |  |  |  |  |  |  |  |  |  |  |  |  | A_H | 0 | 1 | 1 | 1 | DIR (Black = 1) ==> A_H || 1_8 || AH_18 Sinon DIR Black = 0)
 |  | Trolley movement |  |  |  |  |  |  |  |  |  | Motor #1 |  | . |  | Trolley movement |  |  |  |  |  |  |  |  |  | Motor #1 |  | . | 8_1 | 0 | 0 | 1 | 1 | STEP (White = 0) ==> HA_81 || AH_18 Sinon STEP (White = 1)
 |  |  |  |  |  |  |  |  |  |  |  | Dir (34) | HIGH |  |  |  |  |  |  |  |  |  |  |  |  | Dir (34) | LOW |  | 1_8 | 1 | 1 | 1 | 1 | STEP (Black = 0) ==> AH_81 || HA_18 Sinon DIR Black = 1)
 |  |  | 8 |  |  |  |  |  |  |  |  |  |  |  |  |  | 8 |  |  |  |  |  |  |  |  |  |  |  | HA_81 | 0 | 0 | 0 | 1
 |  |  | 7 |  |  |  |  |  |  |  |  |  |  |  |  |  | 7 |  |  |  |  |  |  |  |  |  |  |  | AH_18 | 0 | 1 | 0 | 1
 |  |  | 6 |  |  |  |  |  |  |  |  |  |  |  |  |  | 6 |  |  |  |  |  |  |  |  |  |  |  | HA_18 | 1 | 0 | 1 | 0
 |  |  | 5 |  |  |  |  |  |  |  |  |  |  |  |  |  | 5 |  |  |  |  |  |  |  |  |  |  |  | AH_81 | 0 | 0 | 1 | 0
 |  |  | 4 |  | Coil |  |  |  |  |  |  |  |  |  |  |  | 4 |  |  |  |  |  |  | coil
 |  |  | 3 |  |  |  |  |  |  |  |  |  |  |  |  |  | 3
 |  |  | 2 |  |  |  |  |  |  |  |  |  |  |  |  |  | 2
 |  |  | 1 |  |  |  |  |  |  |  |  |  |  |  |  |  | 1
 |  |  |  | a | b | c | d | e | f | g | h | Motor #2 |  | . |  |  |  | a | b | c | d | e | f | g | h | Motor #2 |  | .
 |  |  |  |  |  |  |  |  |  |  |  | Dir (28) | LOW |  |  |  |  |  |  |  |  |  |  |  |  | Dir (28) | HIGH
 | Movimiento: |  |  |  | 1 | 8 |  |  |  |  |  |  |  |  | Movimiento: |  |  |  | 8 | 1
 |  | Trolley movement |  |  |  |  |  |  |  |  |  | Motor #1 |  | . |  | Trolley movement |  |  |  |  |  |  |  |  |  | Motor #1 |  | .
 |  |  |  |  |  |  |  |  |  |  |  | Dir (34) | HIGH |  |  |  |  |  |  |  |  |  |  |  |  | Dir (34) | LOW
 |  |  | 8 |  |  |  |  |  |  |  |  |  |  |  |  |  | 8
 |  |  | 7 |  |  |  |  |  |  |  |  |  |  |  |  |  | 7 |  |  |  |  |  |  | coil
 |  |  | 6 |  |  |  |  |  |  |  |  |  |  |  |  |  | 6
 |  |  | 5 |  |  |  |  |  |  |  |  |  |  |  |  |  | 5
 |  |  | 4 |  |  |  |  |  |  |  |  |  |  |  |  |  | 4
 |  |  | 3 |  |  |  |  |  |  |  |  |  |  |  |  |  | 3
 |  |  | 2 |  | Coil |  |  |  |  |  |  |  |  |  |  |  | 2
 |  |  | 1 |  |  |  |  |  |  |  |  |  |  |  |  |  | 1
 |  |  |  | a | b | c | d | e | f | g | h | Motor #2 |  | . |  |  |  | a | b | c | d | e | f | g | h | Motor #2 |  | .
 |  |  |  |  |  |  |  |  |  |  |  | Dir (28) | HIGH |  |  |  |  |  |  |  |  |  |  |  |  | Dir (28) | LOW
 | Movimiento: |  |  |  | AH | 18 |  |  |  |  |  |  |  |  | Movimiento: |  |  |  | HA | 81
 |  | Trolley movement |  |  |  |  |  |  |  |  |  | Motor #1 |  | . |  | Trolley movement |  |  |  |  |  |  |  |  |  | Motor #1 |  | .
 |  |  |  |  |  |  |  |  |  |  |  | Dir (34) | HIGH |  |  |  |  |  |  |  |  |  |  |  |  | Dir (34) | LOW
 |  |  | 8 |  |  |  |  |  |  |  |  |  |  |  |  |  | 8
 |  |  | 7 |  |  |  |  |  |  |  |  |  |  |  |  |  | 7 |  |  |  |  |  |  | coil
 |  |  | 6 |  |  |  |  |  |  |  |  |  |  |  |  |  | 6
 |  |  | 5 |  |  |  |  |  |  |  |  |  |  |  |  |  | 5
 |  |  | 4 |  |  |  |  |  |  |  |  |  |  |  |  |  | 4
 |  |  | 3 |  |  |  |  |  |  |  |  |  |  |  |  |  | 3
 |  |  | 2 |  | Coil |  |  |  |  |  |  |  |  |  |  |  | 2
 |  |  | 1 |  |  |  |  |  |  |  |  |  |  |  |  |  | 1
 |  |  |  | a | b | c | d | e | f | g | h | Motor #2 |  | . |  |  |  | a | b | c | d | e | f | g | h | Motor #2 |  | .
 |  |  |  |  |  |  |  |  |  |  |  | Dir (28) | No matter |  |  |  |  |  |  |  |  |  |  |  |  | Dir (28) | No matter
 | Movimiento: |  |  |  | AH | 81 |  |  |  |  |  |  |  |  | Movimiento: |  |  |  | HA | 18
 |  | Trolley movement |  |  |  |  |  |  |  |  |  | Motor #1 |  | . |  | Trolley movement |  |  |  |  |  |  |  |  |  | Motor #1 |  | .
 |  |  |  |  |  |  |  |  |  |  |  | Dir (34) | No matter |  |  |  |  |  |  |  |  |  |  |  |  | Dir (34) | No matter
 |  |  | 8 |  |  |  |  |  |  |  |  |  |  |  |  |  | 8
 |  |  | 7 |  | Coil |  |  |  |  |  |  |  |  |  |  |  | 7
 |  |  | 6 |  |  |  |  |  |  |  |  |  |  |  |  |  | 6
 |  |  | 5 |  |  |  |  |  |  |  |  |  |  |  |  |  | 5
 |  |  | 4 |  |  |  |  |  |  |  |  |  |  |  |  |  | 4 |  |  |  |  |  |  | coil
 |  |  | 3 |  |  |  |  |  |  |  |  |  |  |  |  |  | 3
 |  |  | 2 |  |  |  |  |  |  |  |  |  |  |  |  |  | 2
 |  |  | 1 |  |  |  |  |  |  |  |  |  |  |  |  |  | 1
 |  |  |  | a | b | c | d | e | f | g | h | Motor #2 |  | . |  |  |  | a | b | c | d | e | f | g | h | Motor #2 |  | .
 |  |  |  |  |  |  |  |  |  |  |  | Dir (28) | LOW |  |  |  |  |  |  |  |  |  |  |  |  | Dir (28) | HIGH

Sheet: StepMot
 |  |  |  |  | NEMA 17 26Ncm
 |  |  |  |  | Vcc | 12 V
 |  |  |  |  | Torque max | 26 Ncm
 |  |  |  |  | microstep | 8.00
 |  |  |  |  | Imax | 0.4 A
 |  |  |  |  | L | 37 mH | TBC
 |  |  |  |  | spr | 200 step
 |  |  |  |  | Load | 1000 g
 |  |  |  |  | Load | 9.81 N
 |  |  |  |  | D pulley | 0.6 cm
 |  |  |  |  | Speed max | 2.027027027 rev/s
 | A | B | C | D | T per Step min | 2.466666667 ms
Red |  | X |  |  | Pmax | 4.8 W
Blue |  |  |  | X | Torque mot | 2.943 Ncm
Black | X
Green |  |  | X
 |  |  |  |  | Microstep | Torque
 |  |  |  |  | 1 | 26 Ncm
 |  |  |  |  | 2 | 18.38477631 Ncm
 |  |  |  |  | 4 | 9.949769241 Ncm
 |  |  |  |  | 8 | 5.072348372 Ncm
 |  |  |  |  | 16 | 2.548445649 Ncm
 |  |  |  |  | 32 | 1.275759533 Ncm
 |  |  |  |  | 64 | 0.6380719416 Ncm
 |  |  |  |  | 128 | 0.3190599954 Ncm
 |  |  |  |  | 256 | 0.1595330009 Ncm

Sheet: StepMot Driver
DRV8825
M0 | M1 | M2 | Microstep Resolution | DRV8825 Ilim |  |  |  | Typ | Max
Low | Low | Low | Full step | I MOT | 0.8 A |  | Fpwm | 30 kHz | 250 kHz
High | Low | Low | Half step | I limit | 1 A | Imax 8825 = 2,2A
Low | High | Low | 1/4 step | vref | 2 V
High | High | Low | 1/8 step
Low | Low | High | 1/16 step
High | Low | High | 1/32 step
Low | High | High | 1/32 step
High | High | High | 1/32 step

Sheet: Magnet
https://www.femm.info/wiki/HomePage
Il est dessiné en 2D, vue Y-Z
Le problème est de type planaire.
Matériau IASI 304 Custom pour le blindage magnétique.
Épaisseur du blindage magnétique : 4 mm.
Aimants N35. Diamètre de l’aimant : 8 mm x 3 mm.
Diamètre intérieur du moyeu du blindage magnétique : 10 mm.
Électro-aimant à lévitation, 840 spires. Fil de 0,45 mm, noyau magnétique de 2,41 mm.
Orientation de l’aimant : vers le haut ou vers le bas.
 | B-H courbe pour AISI 304 Custom
 | H (Amp/m) | B (Tesla)
 | 0 | 0
 | 10 | 0.001
 | 100 | 0.01
 | 500 | 0.1
 | 1000 | 0.2
 | 2000 | 0.4
 | 5000 | 0.6
 | 10000 | 0.8
 | 20000 | 1
 | 50000 | 1.1
 | 100000 | 1.2
 | 200000 | 1.3
 | 500000 | 1.4
 | 1000000 | 1.5

Sheet: Square size
 | Displacement Resolution
 | Pulley Ext. Diam | 12.1 mm | By Manufacturer
 | Pulley Int Diam | 5 mm |  |  |  | A | B | C | D | E | F | G | H
 | Pulley witdh | 6 mm |  | - | - | 1 | 2 | 3 | 4 | 5 | 6 | 7 | 8
 |  |  |  | - | - | A | B | C | D | E | F | G | H
 | Belt pitch | 2 mm |  | 8 | 8
 | Belt teeth | 20 teeth |  | 7 | 7
 | Motor step | 200 step |  | 6 | 6
 | Motor µstep | 8 step |  | 5 | 5
 | Square size | 37 mm |  | 4 | 4
 | Linear Resolution | 40 µsteps per mm |  | 3 | 3
 | Square size | 1480 µsteps per square |  | 2 | 2
 | Coeff square size | 185 steps per square | Added in code | 1 | 1
 | distance d Unit | 1 |  | Test results with arduino code (XY)
Only for square table | Coeff diagonal move | 1.414213562 |  | 14:46:55.226 -> Steps on H_A = 1510
 | distance d square | 37 mm |  | 14:46:55.294 -> Distance H_A = 302.00mm |  |  |  | Measured | 300 mm
 | Diagonal move Square | 52.32590181 mm |  | 14:46:55.294 -> Steps on F8_F1 = 1310
 |  |  |  | 14:46:55.327 -> Distance F8_F1 = 262.00mm |  |  |  | Measured | 261 mm
 | Size Table XY | 300 mm | measured
 | Size Table XY | 262 mm | measured | En prenant en compte l'imprécision du test, les résultats sont acceptables
Only for square table | Diagonal | 370.5239533 mm |  | On garde le coeff 185 (les caluls sont corrects)
 |  |  |  | Test results with arduino code (diagonal)
 |  |  |  | 18:32:09.646 -> Steps on HA-18 = 1882
 |  |  |  | 18:32:09.646 -> Distance HA_18 = 376.40mm |  |  |  | Measured | 372mm
 |  |  |  | 18:24:26.638 -> Steps on HA_81 = 1968
 |  |  |  | 18:24:26.638 -> Distance HA_81 = 393.60mm |  |  |  | Measured | 390mm
 |  |  |  | 18:32:09.684 -> Steps on AH_81 = 1884
 |  |  |  | 18:14:44.558 -> Distance AH_81 = 376.80mm |  |  |  | Measured | 372mm
 |  |  |  | 18:24:26.705 -> Steps on HA_18 = 1963
 |  |  |  | 18:24:26.739 -> Distance HA_18 = 392.60mm |  |  |  | Measured | 390mm
 |  |  |  | En prenant en compte l'imprécision du test, les résultats sont acceptables
 |  |  |  | On garde le coeff 1,41 (les caluls sont corrects)
 |  |  |  |  |  | 380.2
 | https://www.norwegiancreations.com/2015/07/tutorial-calibrating-stepper-motor-machines-with-belts-and-pulleys/
 |  | 1.414213562

Sheet: Electromagnet1
https://www.kjmagnetics.com/magnetic-field-calculator.asp
https://www.production-solution.com/coil-calculator.htm
Force aimant nécessaire |  |  | Données Electro aimant
Poids 4 rondelles | 0.007 kg |  | Dw | Wire.Diameter | 0.45 mm
diamètre noyau | 0.008 m |  | N | Number of Turns | 840
hauteur noyau | 0.003 m |  | Lb | Bobbin Length | 22 mm
Induction rémanente | 1.2 T | ISO 60404-8-1 | Db | Core Diameter | 8 mm
Poids pièce echec | 0.012 Kg |  | k | Permeability on Air | 1.256637061e-06 m
Densité neodyme | 7500 Kg/m3 |  | I | Current Designed | 2 A
coeff frottement plexiglas | 0.2 Kg/m3 |  | g | Gap | 7 mm
acceleration aimant | 1 m/s² |  | TpW | Turns per Layer (Turns per Winding) | 48.88888889 | TpW= Lb/Dw;
Volume noyau | 1.507964474e-07 m3 |  | W | Number of Layers: Windings | 17.18181818 | W=N/TpW;
masse aimant | 0.001130973355 kg |  | A | Cross Section Area | 194.3782726 mm² | A= PI*Rw*Rw;
Force min | 0.1974848486 N |  | Rw | Average Radius of Coil | 7.865909091 mm | Rw= (W*Dw+ Db)/2;
Force frottement | 0.03949696972 N |  | Dc | Outer Diameter of Coil | 23.46363636 mm | Dc= (2*W*Dw+Db);
Force inertie | 0.02013097336 N |  | Dm | Diameter to middle of the Coil | 15.73181818 mm | Dm=(Dc-Db)/2+Db;
 |  |  | LpT | Average Length Turn | 49.42296443 mm | LpT= 2*PI*Rw;
Force mécanique totale | 0.2571127917 N |  | L | Length | 41.51529012 m | L= LpT*N/KILO;
 |  |  | RpM | Resistance Per Meter | 0.1074486519 Ohm/m | RpM=0,033*((0.812/2)*(0.812/2))/((Dw/2)*(Dw/2));
 |  |  | A0 | Cross section for force calculation | 50.26548246 mm² | A0= PI*Math.pow((Db/2),2)
 |  |  | Ww | Wire Weight | 0.05866687837 kg | Ww= (L/(51.05/(((Dw/2)*(Dw/2))*PI)))*.45359237;
 |  |  | R | Total Resistance | 4.460761955 Ohm | R= RpM*L;
 |  |  | H | Inductance in Micro Henries | 6005.265179 µH | H=(Dm*.001*Dm*.001*N*N)/(Lb*.001+.45*Dm*.001);
 |  |  | F | Force | 1.819165483 N | F= (N*I)*(N*I)*K*A0/(2*g*g);
 |  |  | V | Voltage | 8.921523909 V | V=I.R
 |  |  | P | Power | 17.84304782 W | P=V.I

Sheet: Electromagnet2
https://www.youtube.com/watch?v=vHP-zq23uvE&t=15s
 |  |  | I = V/ R | B =N*I*µ0 * Core Effective Permeability / Core Lenght | F =B^2 * Core Area / (2 * µ0 ) | P = I^2xR
N [Number of Turns] | Length [m] | Resistance [Ohm] | Current [Ampere] | B [Tesla] | Force [Newton] | Power [Watt] | Weight [ Grams] | Core Effective permeability | Vacuum permeability | B MIN |  | Courant | Section
1 | 0.0251 | 0.0053 | 0.80 | 0.000119 | 2.844889162e-07 | 0.003398 | 2.844889162e-05 | 2.61H/m | 1.256637061e-06H/m | 2T |  | 0 | 0.0000
5 | 0.1257 | 0.0265 | 0.80 | 0.000596 | 0.000007 | 0.016991 | 0.0007112222904 |  |  |  |  | 0.1 | 0.0500
10 | 0.2513 | 0.0531 | 0.80 | 0.001193 | 0.000028 | 0.033982 | 0.002844889162 | Voltage | Current Limit | Resistivity |  | 0.2 | 0.1000
20 | 0.5027 | 0.1062 | 0.80 | 0.002385 | 0.000114 | 0.067963 | 0.01 | 20V | 0.8A | 0.0336 |  | 0.3 | 0.1500
30 | 0.7540 | 0.1593 | 0.80 | 0.003578 | 0.000256 | 0.101945 | 0.03 |  |  |  | Ohm*mm^2/m | 0.4 | 0.2000
40 | 1.0053 | 0.2124 | 0.80 | 0.004771 | 0.000455 | 0.135927 | 0.05 | Wire Radius | Core Radius | Core Lenght |  | 0.5 | 0.2500
50 | 1.2566 | 0.2655 | 0.80 | 0.005963 | 0.000711 | 0.169908 | 0.07 | 0.225mm | 4mm | 22mm |  | 0.6 | 0.3000
60 | 1.5080 | 0.3186 | 0.80 | 0.007156 | 0.001024 | 0.203890 | 0.10 |  |  |  |  | 0.7 | 0.3500
70 | 1.7593 | 0.3717 | 0.80 | 0.008349 | 0.001394 | 0.237871 | 0.14 | Wire Area [mm2] | Current density | Wire Max Current |  | 0.8 | 0.4000
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
19700 | 495.1150 | 104.5997 | 0.19 | 0.561556 | 6.306914 | 3.824103 | 630.69
19800 | 497.6283 | 105.1307 | 0.19 | 0.561556 | 6.306914 | 3.804789 | 630.69
19900 | 500.1416 | 105.6616 | 0.19 | 0.561556 | 6.306914 | 3.785669 | 630.69
20000 | 502.6548 | 106.1926 | 0.19 | 0.561556 | 6.306914 | 3.766741 | 630.69
20100 | 505.1681 | 106.7236 | 0.19 | 0.561556 | 6.306914 | 3.748001 | 630.69
20200 | 507.6814 | 107.2545 | 0.19 | 0.561556 | 6.306914 | 3.729447 | 630.69
20300 | 510.1946 | 107.7855 | 0.19 | 0.561556 | 6.306914 | 3.711075 | 630.69
20400 | 512.7079 | 108.3164 | 0.18 | 0.561556 | 6.306914 | 3.692883 | 630.69
20500 | 515.2212 | 108.8474 | 0.18 | 0.561556 | 6.306914 | 3.674869 | 630.69
20600 | 517.7345 | 109.3784 | 0.18 | 0.561556 | 6.306914 | 3.657030 | 630.69
20700 | 520.2477 | 109.9093 | 0.18 | 0.561556 | 6.306914 | 3.639363 | 630.69
20800 | 522.7610 | 110.4403 | 0.18 | 0.561556 | 6.306914 | 3.621866 | 630.69
20900 | 525.2743 | 110.9713 | 0.18 | 0.561556 | 6.306914 | 3.604537 | 630.69
21000 | 527.7876 | 111.5022 | 0.18 | 0.561556 | 6.306914 | 3.587372 | 630.69
21100 | 530.3008 | 112.0332 | 0.18 | 0.561556 | 6.306914 | 3.570371 | 630.69

Sheet: Electromagnet Driver
L298N
ENA | IN1 | IN2 | Output |  | Typ | Max
L | X | X | Free wheel output | Fpwm | 25 kHz | 40 kHz
H | L | L | output locked
 | L | H | Drive |  | Max
 | H | L | Rear | Imax L298 | 2 A
 | H | H | output locked | I magnet | 0.25 A
