shavyy/Automated_Chess/21_Modelisation_3D/Pulley_Support_B.stl

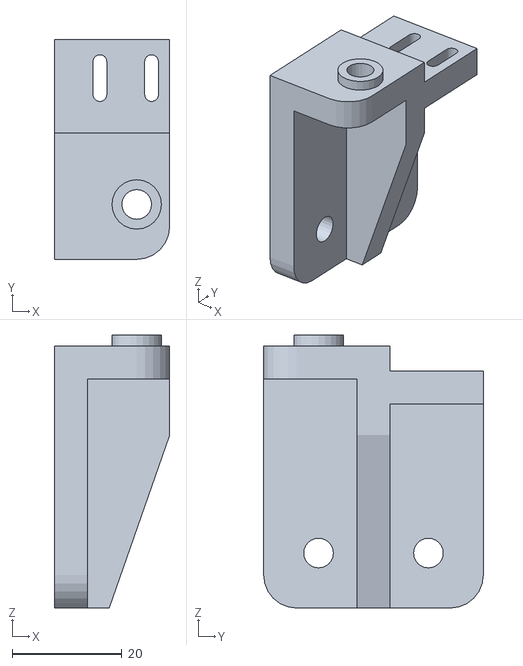
[picture p22: CAD file, 2025-01-22]
21_Modelisation_3D/Pulley_Support_B.stl
21.0 x 40.0 x 49.7
