shavyy/Automated_Chess/21_Modelisation_3D/Pulley_Support_A.stl

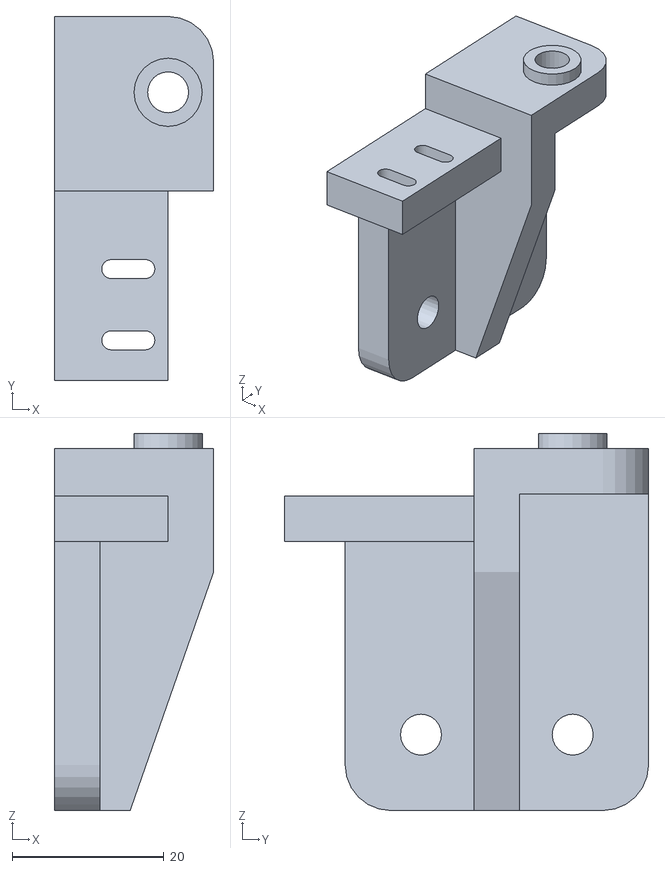
[picture p23: CAD file, 2025-01-22]
21_Modelisation_3D/Pulley_Support_A.stl
21.0 x 48.0 x 49.7
