shavyy/Automated_Chess/21_Modelisation_3D/Trolley_Support_B.stl

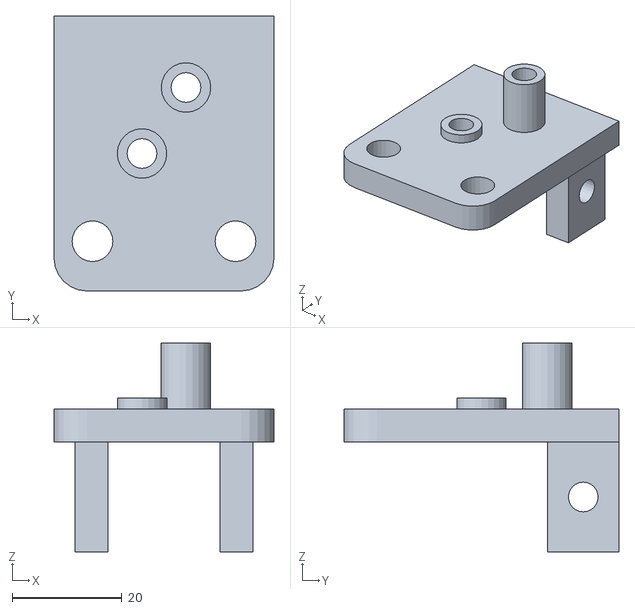
[picture p24: CAD file, 2025-01-22]
21_Modelisation_3D/Trolley_Support_B.stl
40.0 x 50.0 x 38.0
