shavyy/Automated_Chess/21_Modelisation_3D/Trolley_Support_A.stl

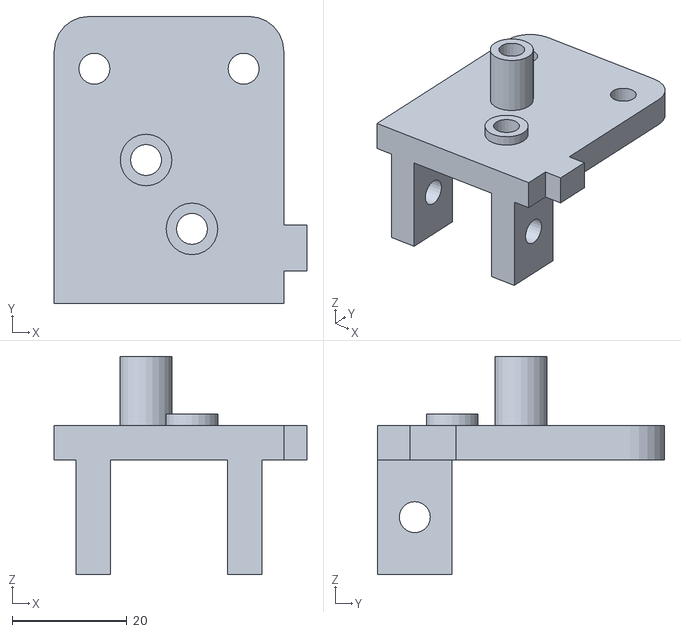
[picture p25: CAD file, 2025-01-22]
21_Modelisation_3D/Trolley_Support_A.stl
44.0 x 50.0 x 38.0
