shavyy/Automated_Chess/21_Modelisation_3D/Electromagnet_Support.stl

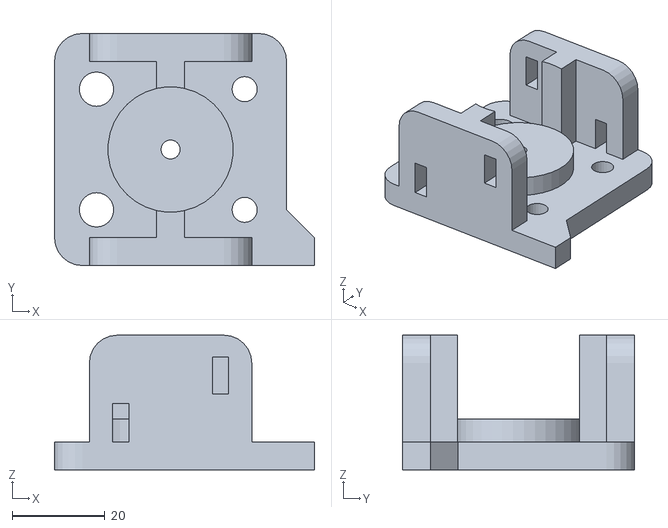
[picture p26: CAD file, 2025-01-22]
21_Modelisation_3D/Electromagnet_Support.stl
56.0 x 50.0 x 29.0
