shavyy/Automated_Chess/21_Modelisation_3D/Arduino Mega 2560 - STL.stl

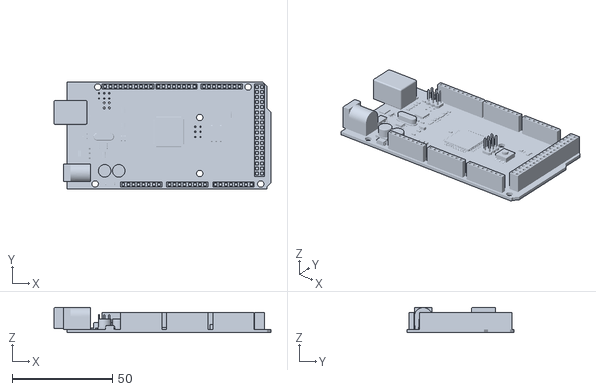
[picture p27: CAD file, 2025-01-22]
21_Modelisation_3D/Arduino Mega 2560 - STL.stl
108.1 x 53.3 x 12.5
