shavyy/Automated_Chess/21_Modelisation_3D/Motor_Support_A.stl

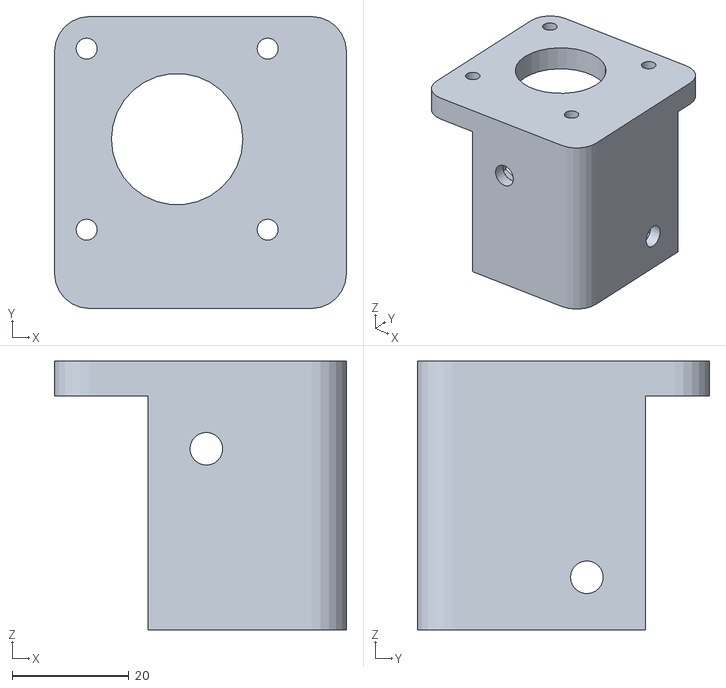
[picture p28: CAD file, 2025-01-22]
21_Modelisation_3D/Motor_Support_A.stl
50.0 x 50.0 x 46.0
