shavyy/Automated_Chess/21_Modelisation_3D/Cable_Clip.stl

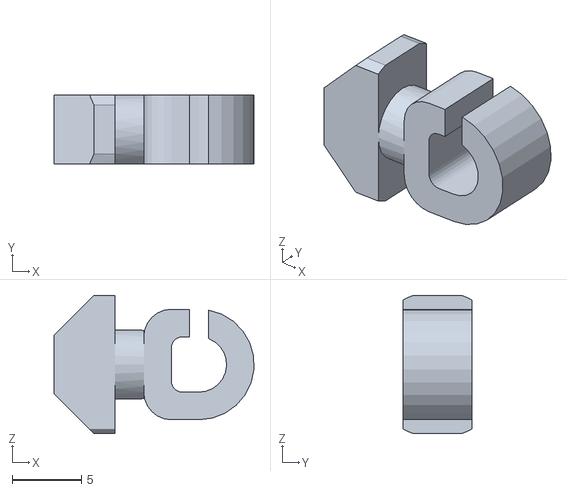
[picture p29: CAD file, 2025-01-22]
21_Modelisation_3D/Cable_Clip.stl
14.5 x 5.00 x 10.0
