shavyy/Automated_Chess/21_Modelisation_3D/Electronic_Support_B.stl

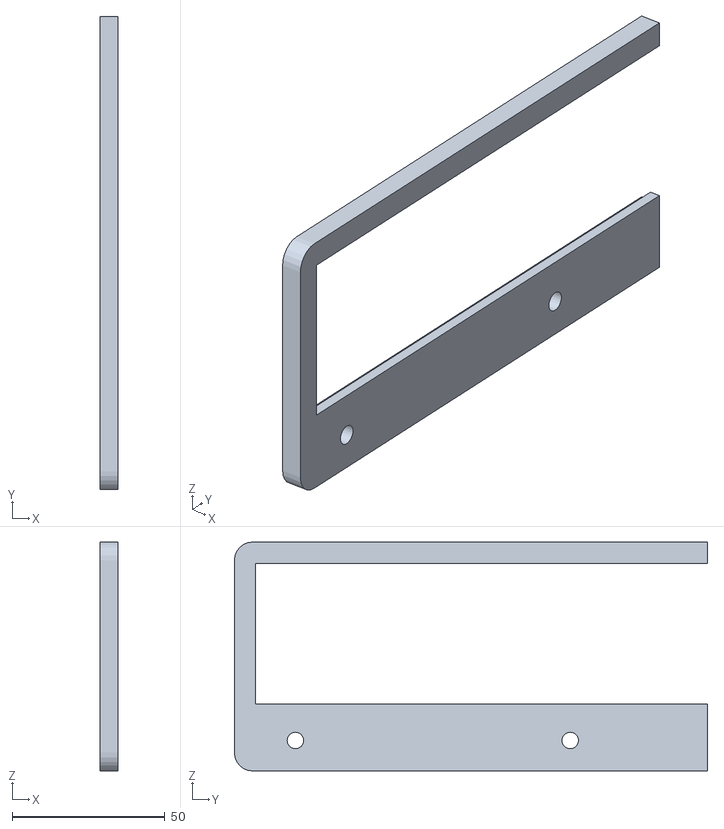
[picture p30: CAD file, 2025-01-22]
21_Modelisation_3D/Electronic_Support_B.stl
6.00 x 155.0 x 75.0
