shavyy/Automated_Chess/21_Modelisation_3D/Electronic_Support_A.stl

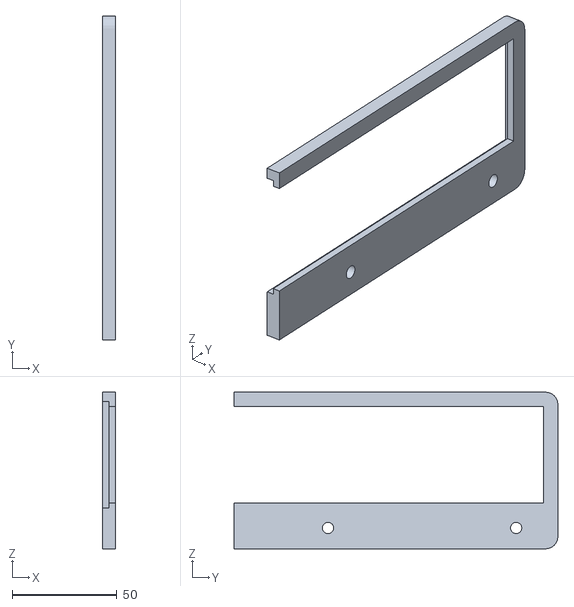
[picture p31: CAD file, 2025-01-22]
21_Modelisation_3D/Electronic_Support_A.stl
6.00 x 155.0 x 75.0
