shavyy/Automated_Chess/(list of files, cad)

Other CAD files:
21_Modelisation_3D/Motor_Support_B.stl
