shavyy/Automated_Chess/10_Image/3D_Automated_chess-Automated chessboard assembly V1.0 v32_biais.png

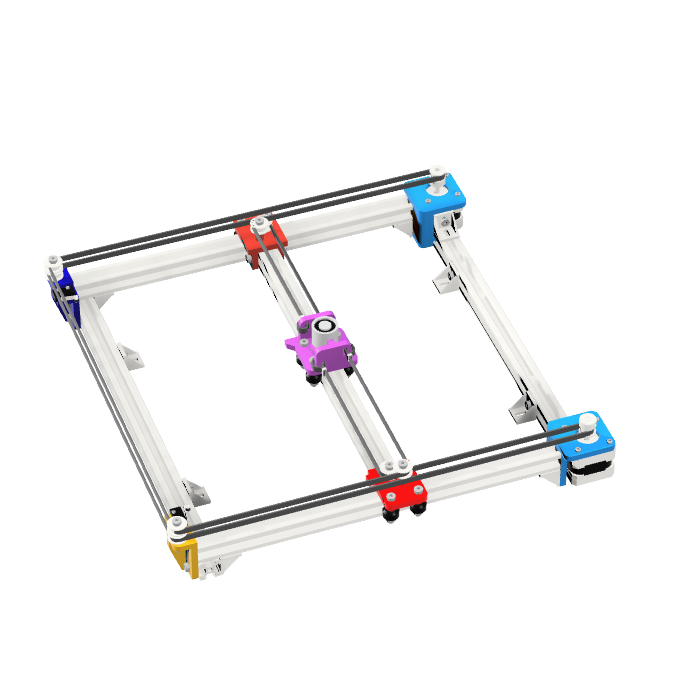
10_Image/3D_Automated_chess-Automated chessboard assembly V1.0 v32_biais.png
