shavyy/Automated_Chess/(list of files, drawings)

Other design files:
20_schema/Hall sensor board/SCH_automated_chess_2024-11-14.json
