shavyy/Automated_Chess/22_code/microMax_V1.cpp

//  V3 October 2024, only add as Global the black_player_movement() for made the last move before CheckMate
//  V2 October 2024, only add a display for show the winner
// ******************************  INCLUDING FILES
#include "Arduino.h"
#include "Ai_V1.h"  

// La declaración extern simplemente le dice al compilador que el objeto existe y está definido en algún otro lugar
// (en este caso, en el archivo .ino). 
// De esta manera, el archivo .cpp puede usar el objeto lcd sin tener que definirlo nuevamente.

#include <LiquidCrystal_I2C.h> // V2 // verify is the same lab you have on .ino file
extern LiquidCrystal_I2C lcd; // V2

// Declaración de la función que está en el archivo .ino // V3
extern void black_player_movement();                      // V3

// ************************************  VARIABLES
#define W while
#define M 0x88
#define S 128
#define I 8000

#define MYRAND_MAX 65535     /* 16bit pseudo random generator */
long  N, T;                  /* N=evaluated positions+S, T=recursion limit */
short Q, O, K, R, k = 16;    /* k=moving side */
char *p, c[5], Z;            /* p=pointer to c, c=user input, computer output, Z=recursion counter */

char L,
     w[] = {0, 2, 2, 7, -1, 8, 12, 23},                    /* relative piece values    */
           o[] = { -16, -15, -17, 0, 1, 16, 0, 1, 16, 15, 17, 0, 14, 18, 31, 33, 0, /* step-vector lists */
                   7, -1, 11, 6, 8, 3, 6,                           /* 1st dir. in o[] per piece*/
                   6, 3, 5, 7, 4, 5, 3, 6
                 };                                /* initial piece setup      */
/* board is left part, center-pts table is right part, and dummy */

char b[] = {
  22, 19, 21, 23, 20, 21, 19, 22, 28, 21, 16, 13, 12, 13, 16, 21,
  18, 18, 18, 18, 18, 18, 18, 18, 22, 15, 10,  7,  6,  7, 10, 15,
  0,  0,  0,  0,  0,  0,  0,  0, 18, 11,  6,  3,  2,  3,  6, 11,
  0,  0,  0,  0,  0,  0,  0,  0, 16,  9,  4,  1,  0,  1,  4,  9,
  0,  0,  0,  0,  0,  0,  0,  0, 16,  9,  4,  1,  0,  1,  4,  9,
  0,  0,  0,  0,  0,  0,  0,  0, 18, 11,  6,  3,  2,  3,  6, 11,
  9,  9,  9,  9,  9,  9,  9,  9, 22, 15, 10,  7,  6,  7, 10, 15,
  14, 11, 13, 15, 12, 13, 11, 14, 28, 21, 16, 13, 12, 13, 16, 21, 0
};

char bk[16 * 8 + 1];

unsigned int seed = 0;
uint32_t  byteBoard[8];

char sym[17] = {".?pnkbrq?P?NKBRQ"};
int mn = 1;
char lastH[5], lastM[5];
unsigned short ledv = 1;

String inputString = "";
bool stringComplete = false;  // whether the string is complete

int r;

// ***************************************  MYRAND
unsigned short myrand(void) {
  unsigned short r = (unsigned short)(seed % MYRAND_MAX);
  return r = ((r << 11) + (r << 7) + r) >> 1;
}
/* recursive minimax search */
/* (q,l)=window, e=current eval. score, */
/* E=e.p. sqr.z=prev.dest, n=depth; return score */
short D(short q, short l, short e, unsigned char E, unsigned char z, unsigned char n) {
  short m, v, i, P, V, s;
  unsigned char t, p, u, x, y, X, Y, H, B, j, d, h, F, G, C;
  signed char r;
  if (++Z > 30) {                                   /* stack underrun check */
    --Z; return e;
  }
  q--;                                          /* adj. window: delay bonus */
  k ^= 24;                                      /* change sides             */
  d = Y = 0;                                    /* start iter. from scratch */
  X = myrand() & ~M;                            /* start at random field    */
  W(d++ < n || d < 3 ||                         /* iterative deepening loop */
    z & K == I && (N < T & d < 98 ||            /* root: deepen upto time   */
                   (K = X, L = Y & ~M, d = 3)))                /* time's up: go do best    */
  { x = B = X;                                   /* start scan at prev. best */
    h = Y & S;                                   /* request try noncastl. 1st*/
    P = d < 3 ? I : D(-l, 1 - l, -e, S, 0, d - 3); /* Search null move         */
    m = -P < l | R > 35 ? d > 2 ? -I : e : -P;   /* Prune or stand-pat       */
    ++N;                                         /* node count (for timing)  */
    do {
      u = b[x];                                   /* scan board looking for   */
      if (u & k) {                                /*  own piece (inefficient!)*/
        r = p = u & 7;                             /* p = piece type (set r>0) */
        j = o[p + 16];                             /* first step vector f.piece*/
        W(r = p > 2 & r < 0 ? -r : -o[++j])        /* loop over directions o[] */
        { A:                                        /* resume normal after best */
          y = x; F = G = S;                         /* (x,y)=move, (F,G)=castl.R*/
          do {                                      /* y traverses ray, or:     */
            H = y = h ? Y ^ h : y + r;               /* sneak in prev. best move */
            if (y & M)break;                         /* board edge hit           */
            m = E - S & b[E] && y - E < 2 & E - y < 2 ? I : m; /* bad castling             */
            if (p < 3 & y == E)H ^= 16;              /* shift capt.sqr. H if e.p.*/
            t = b[H]; if (t & k | p < 3 & !(y - x & 7) - !t)break; /* capt. own, bad pawn mode */
            i = 37 * w[t & 7] + (t & 192);           /* value of capt. piece t   */
            m = i < 0 ? I : m;                       /* K capture                */
            if (m >= l & d > 1)goto C;               /* abort on fail high       */
            v = d - 1 ? e : i - p;                   /* MVV/LVA scoring          */
            if (d - !t > 1)                          /* remaining depth          */
            { v = p < 6 ? b[x + 8] - b[y + 8] : 0;    /* center positional pts.   */
              b[G] = b[H] = b[x] = 0; b[y] = u | 32;  /* do move, set non-virgin  */
              if (!(G & M))b[F] = k + 6, v += 50;     /* castling: put R & score  */
              v -= p - 4 | R > 29 ? 0 : 20;           /* penalize mid-game K move */
              if (p < 3)                              /* pawns:                   */
              { v -= 9 * ((x - 2 & M || b[x - 2] - u) + /* structure, undefended    */
                          (x + 2 & M || b[x + 2] - u) - 1  /*        squares plus bias */
                          + (b[x ^ 16] == k + 36))          /* kling to non-virgin King */
                     - (R >> 2);                       /* end-game Pawn-push bonus */
                V = y + r + 1 & S ? 647 - p : 2 * (u & y + 16 & 32); /* promotion or 6/7th bonus */
                b[y] += V; i += V;                     /* change piece, add score  */
              }
              v += e + i; V = m > q ? m : q;          /* new eval and alpha       */
              C = d - 1 - (d > 5 & p > 2 & !t & !h);
              C = R > 29 | d < 3 | P - I ? C : d;     /* extend 1 ply if in check */
              do
                s = C > 2 | v > V ? -D(-l, -V, -v,     /* recursive eval. of reply */
                                       F, 0, C) : v;    /* or fail low if futile    */
              W(s > q&++C < d); v = s;
              if (z && K - I && v + I && x == K & y == L) /* move pending & in root:  */
              { Q = -e - i; O = F;                     /*   exit if legal & found  */
                R += i >> 7; --Z; return l;            /* captured non-P material  */
              }
              b[G] = k + 6; b[F] = b[y] = 0; b[x] = u; b[H] = t; /* undo move,G can be dummy */
            }
            if (v > m)                               /* new best, update max,best*/
              m = v, X = x, Y = y | S & F;            /* mark double move with S  */
            if (h) {
              h = 0;  /* redo after doing old best*/
              goto A;
            }
            if (x + r - y | u & 32 |                 /* not 1st step,moved before*/
                p > 2 & (p - 4 | j - 7 ||             /* no P & no lateral K move,*/
                         b[G = x + 3 ^ r >> 1 & 7] - k - 6     /* no virgin R in corner G, */
                         || b[G ^ 1] | b[G ^ 2])               /* no 2 empty sq. next to R */
               )t += p < 5;                           /* fake capt. for nonsliding*/
            else F = y;                              /* enable e.p.              */
          } W(!t);                                  /* if not capt. continue ray*/
        }
      }
    } W((x = x + 9 & ~M) - B);                 /* next sqr. of board, wrap */
C: if (m > I - M | m < M - I)d = 98;           /* mate holds to any depth  */
    m = m + I | P == I ? m : 0;                  /* best loses K: (stale)mate*/
    if (z && d > 2)
    { *c = 'a' + (X & 7); c[1] = '8' - (X >> 4); c[2] = 'a' + (Y & 7); c[3] = '8' - (Y >> 4 & 7); c[4] = 0;
      char buff[150];
    }
  }                                             /*    encoded in X S,8 bits */
  k ^= 24;                                      /* change sides back        */
  --Z; return m += m < e;                       /* delayed-loss bonus       */
}

// ************************************  GAME OVER //V2 added display the Winner
void gameOver() {
  // La variable k cambia de valor entre 0x10 y 0x08 en cada turno para indicar el jugador activo.
  // Esto significa que, cuando se llama a gameOver(), el valor actual de k indica cuál fue el último jugador
  // en moverse antes de la finalización.
  // Falta adecuar la logica para cuando gameOver() es llamado por falta de tiempo.
  
  if (k == 0x10) {  
    
    if(game_mode == 1) {// en HvsC=0; HvsC=1
      black_player_movement(); // Go to ino file for make the last move and returns here // V3
    }
    Serial.println("Black wins!"); // Las piezas negras ganan
    lcd.setCursor(0, 0);
    lcd.print(" PLAYER BLACK   ");
    lcd.setCursor(0, 1);
    lcd.print("      WINS      ");
  } else {
    Serial.println("White wins!"); // Las piezas blancas ganan
    lcd.setCursor(0, 0);
    lcd.print(" PLAYER WHITE   ");
    lcd.setCursor(0, 1);
    lcd.print("      WINS      ");
  }
  for (;;); // bucle infinito para detener el Arduino
}

// ******************************************  BKP
void bkp() {
  for (int i = 0; i < 16 * 8 + 1; i++) {
    bk[i] = b[i];
  }
}

// *********************************  SERIAL BOARD
void serialBoard() {
  Serial.println("  +-----------------+");
  for (int i = 0; i < 8; i++) {
    Serial.print(' ');
    Serial.print(8 - i);
    Serial.print("| ");
    for (int j = 0; j < 8; j++) {
      char c = sym[b[16 * i + j] & 15];  // SPK la variable c, La operación AND con 15 se realiza para extraer los últimos 4 bits del valor almacenado en la celda actual. Estos últimos 4 bits representan el tipo de pieza de ajedrez que se encuentra en esa celda (por ejemplo, peón, caballo, torre, etc.). El valor resultante de esta operación AND se utiliza para indexar un array de caracteres llamado "sym". Este array contiene los símbolos correspondientes a cada tipo de pieza de ajedrez (por ejemplo, 'P' para peón, 'N' para caballo, 'R' para torre, etc.). Por lo tanto, la línea de código completa "char c = sym[b[16 * i + j] & 15];" se utiliza para obtener el símbolo correspondiente a la pieza de ajedrez en la celda actual del tablero, que se almacena en la variable "c".
      Serial.print(c);
      Serial.print(' ');
    }
    Serial.println('|');
  }
  Serial.println("  +-----------------+");
  Serial.println("   a b c d e f g h");
}

// ******************************  AI HUMAN PLAYER
void AI_HvsH() {
  // Take move from human
  inputString += mov;
  if (sequence == 3) {
    Serial.print(mn);
    Serial.print(". ");
  }
  else if (sequence == 4) Serial.print("   ");

  Serial.print(inputString.substring(0, 4));
  c[0] = inputString.charAt(0);
  c[1] = inputString.charAt(1);
  c[2] = inputString.charAt(2);
  c[3] = inputString.charAt(3);
  c[4] = 0;
  // clear the string:
  inputString = "";
  stringComplete = false;

  K = *c - 16 * c[1] + 799, L = c[2] - 16 * c[3] + 799; /* parse entered move */
  N = 0;
  T = 0x3F;                                 /* T=Computer Play strength */
  bkp();                                    /* Save the board just in case */
  r = D(-I, I, Q, O, 1, 3);                 /* Check & do the human movement */
  if ( !(r > -I + 1) ) {
    Serial.println("Lose ");
    gameOver();
  }

  if (sequence == 3) {
    if (k == 0x10) {                          /* The flag turn must change to 0x08 */
      Serial.println("  No valid move");
      no_valid_move = true;
      return;
    }
    strcpy(lastH, c);                         /* Valid human movement */
    Serial.println("");
    serialBoard();
  }

  if (sequence == 4) {
    if (k == 0x08) {
      Serial.println("  No valid move");
      no_valid_move = true;
      return;
    }
    strcpy(lastM, c);
    r = D(-I, I, Q, O, 1, 3);
    if ( !(r > -I + 1) ) {
      gameOver();
    }
    Serial.println("");
    serialBoard();
  }
  if (sequence == 3) mn++; /* Next move */
}

// ***************************  AI COMPUTER PLAYER
void AI_HvsC() {

  // Take move from human
  inputString += mov;
  Serial.print(mn);
  Serial.print(". ");
  Serial.print(inputString.substring(0, 4));
  c[0] = inputString.charAt(0);
  c[1] = inputString.charAt(1);
  c[2] = inputString.charAt(2);
  c[3] = inputString.charAt(3);
  c[4] = 0;
  // clear the string:
  inputString = "";
  stringComplete = false;
  Serial.print(" Think ");                       /* Turn for ARDUINO */

  K = *c - 16 * c[1] + 799, L = c[2] - 16 * c[3] + 799; /* parse entered move */
  N = 0;
  T = 0x3F;                                 /* T=Computer Play strength */
  bkp();                                    /* Save the board just in case */
  r = D(-I, I, Q, O, 1, 3);                 /* Check & do the human movement */
  if ( !(r > -I + 1) ) {
    Serial.println("Lose ");
    gameOver();
  }
  if (k == 0x10) {                          /* The flag turn must change to 0x08 */
    Serial.println("No valid move");
    no_valid_move = true; // V9
    return;
  }

  strcpy(lastH, c);                         /* Valid human movement */

  mn++;                                     /* Next move */

  K = I;
  N = 0;
  T = 0x3F;                                 /* T=Computer Play strength */
  r = D(-I, I, Q, O, 1, 3);                 /* Think & do*/
  if ( !(r > -I + 1) ) {
    Serial.println("Lose*");
    gameOver();
  }

  strcpy(lastM, c);                         /* Valid ARDUINO movement */
  r = D(-I, I, Q, O, 1, 3);
  if ( !(r > -I + 1) ) {
    Serial.println(lastM);
    gameOver();
  }
  Serial.println(lastM);
  serialBoard();
}
