shavyy/Automated_Chess/(commit log)

2025-01-22 first add
    [SCH_automated_chess_2024-11-14.json]
2025-01-29 maj electo magnet + IA
2025-07-24 add sg90 servomot spec
2025-07-24 update chapter piece, electromagnet + add servomot
2025-07-24 add magnetic simulation + update electromagnet
    [Design.xlsx]
